MDJGyurgeiz/CAMMES/(commit log)

2026-03-09 Progetto CAMMES completo: PC + Arduino + Android
    - App Windows (cammes.exe) con server Node.js + interfaccia web
    - Pagine: Alzata, Analisi cinematica, Polare, Grafici
    - Sketch Arduino: master.ino + micrometro_SPI.ino
    - App Android con WebView + USB Serial bridge
    - APK compilato pronto per installazione
    [camme-analisi_rev8.5.xlsm]
2026-05-02 Fase A: pulizia e allineamento documentazione/repo
    - Fix README.md: pin stepper corretti (PUL=7, DIR=6, ENA=5), porta HTTP 3000 (era 8080), nota architettura in transizione 2-Uno → 1-Uno
    - CHANGELOG.md: sessione 4 di pulizia, allineato Uno (era Mega), spuntati TODO già implementati ('q' e reset buffer SPI), aggiunti TODO Fase B/C/D
    - Rimossi binari dal tree: cammes.exe, cammes_server.exe, CAMMES.apk (saranno distribuiti via GitHub Releases)
    - Rimossa cartella cammes/charts/ (sorgenti+test+docs Chart.js non necessari a runtime, ~67k righe)
    - Spostato cammes/charts/jquery.min.js → cammes/jquery.min.js, aggiornati riferimenti in alzata.html, polare.html e package.json (config pkg)
    - Rimoss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
2026-05-02 analisi.html: tipologia punteria, forze molla/RPM critico, export CSV/PDF
    Estende la pagina analisi.html per supportare l'analisi completa di camme con
    diverse tipologie di punteria e calcolare il regime critico (cam float).
    UI:
    - Selettore tipologia per intake e exhaust (bicchiere meccanico/idraulico,
    aste+bilancere, finger follower, bilancere a rullo) con default rocker
    e gioco coerenti per ogni tipo. Idraulico forza gioco=0.
    - Nuova sezione "Parametri molla & treno valvole": rigidezza k (N/mm),
    precarico F0 (N), massa equivalente intake/exhaust (g).
    - Nuova sezione risultati "Forze molla e RPM critico": forza inerzia max,
    forza molla a piena alzata, margine minimo, RPM critico pe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
2026-05-02 style.css: redesign 'race telemetry' coerente col contesto camme
    Tutte le pagine adottano un'identita' visiva piu' tecnica e contestualizzata
    all'analisi alberi a camme / motorsport.
    Header (HUD bar):
    - Strip cyan luminosa sul bordo superiore
    - Pattern diagonale di accenti racing nell'angolo destro
    - Logo con drop-shadow ciano
    - Titolo CAMMES con gradient ciano (font display Rajdhani con fallback system)
    - Tab nav con marker sottostante e box-shadow di glow per il tab attivo
    Card (telemetry panel):
    - Sfondo a gradiente verticale (elev -> base) per profondita'
    - Marker cyan verticale a sinistra del titolo (stile HUD)
    - Hover: bordo si rinforza (interazione tattile)
    - Card-title in font disp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
2026-05-03 Fase B: unificazione firmware su 1 Arduino Uno + encoder LDP3806
    Sostituzione completa dell'architettura a 2 Uno (master + sensore via SPI)
    con un singolo Arduino Uno che gestisce: stepper esterno opto-isolato,
    encoder rotativo LDP3806 sull'albero camme (1:1, 360 PPR, decoding x4),
    sensore Neoteck via LM339N, UART verso server PC.
    Pinout finale Uno:
    - D2 (INT0) sensore Neoteck clock impulsi
    - D5 sensore Neoteck DATA
    - D3 (INT1) encoder canale A
    - D8 (PCINT0) encoder canale B
    - D7/D6/D4 stepper PUL-/DIR-/ENA- (driver opto common-anode, 5V su +)
    - D0/D1 UART USB-PC
    Firmware (master/master.ino) riscritto da zero:
    - Lettura sensore Neoteck integrata (16 bit utili, dal 2°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
2026-05-03 firmware: ripristina pin storici stepper (PUL=7, DIR=6, ENA=5), DATA sensore su D4
    Ripristinato il pinout del progetto iniziale per il driver stepper. Il DATA
    del sensore Neoteck (LM339N pin 14) si sposta da D5 a D4, dato che ENA stepper
    torna sul pin storico D5.
    Effetto pratico sul cablaggio: solo 1 filo da spostare sul prototipo (LM339N
    pin 14 da D5 a D4). Tutto il resto resta come da progetto.
    Pinout finale:
    - D2 (INT0) LM339N pin 2 — clock impulsi sensore
    - D4 LM339N pin 14 — DATA bit sensore [spostato]
    - D3 (INT1) encoder A
    - D8 (PCINT0) encoder B
    - D7 stepper PUL- [pin storico]
    - D6 stepper DIR- [pin storico]
    - D5 stepper ENA- [pin storico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
2026-05-03 firmware: fix lettura sensore (LSB mancante) + comandi m/d alzata.html: indicatori stato sensori + fix bug 'mic out'
    FIRMWARE
    - Fix critico: la finestra di lettura del sensore Neoteck era bit 2..17.
    In realtà il sensore mette il LSB sul bit 1, non sul 2.
    Risultato: il valore letto era esattamente la metà di quello vero
    (verificato: comparatore 8.484 mm, digitale 4.24 mm pre-fix; post-fix 8.48).
    - Spostata finestra a bit 1..16. Ora la lettura coincide col display
    del comparatore con scarto < 0.005 mm (rumore di quantizzazione).
    - Nuovo comando 'm': measure-only, legge il sensore SENZA muovere il motore.
    - Nuovo comando 'd': debug, stampa raw value + decimale + binario + bitIdx.
    Ut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
    [full_scan_2026-05-03.csv]
2026-05-03 alzata.html: LED sensore multi-stato + auto-stop su sensore scollegato
    LED Sensore ora ha 3 stati:
    - VERDE: misure valide ricevute negli ultimi 3s
    - GIALLO: arrivano NaN dal firmware (sensore Neoteck scollegato/non risponde)
    - ROSSO: nessun frame dal firmware da > 5s (Arduino non risponde)
    Auto-stop scan: se durante una scansione arrivano 3 NaN consecutivi, la pagina
    ferma automaticamente startflag e chiama stop(). Evita di lasciare il motore
    girare a vuoto se il comparatore si scollega a metà scansione.
    Display 'mic out' rinominato in 'NO SENSORE' (più chiaro per chi non sa cos'e'
    'mic out').
    Bug fix latente: variabili startflag, stepflag, i ora dichiarate esplicitamente
    con var all'in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
2026-05-03 alzata.html: fix bug 'parte a leggere da solo' al reload pagina
    Il blocco di avanzamento scansione (riga 314) si attivava su QUALSIASI
    messaggio che iniziava con '*' (incluso *pos del polling encoder, *zero
    del reset, *dbg del debug). Risultato: ogni 5s il polling '?' riceveva
    '*pos', il vecchio codice lo interpretava come 'misura terminata, vai
    avanti' e mandava 'p' ad Arduino → loop infinito di scansione che
    partiva da solo dopo qualche secondo dal caricamento pagina.
    Fix: condizione molto più stretta:
    - msg === '*se' (solo terminatore di misura, non altri *xyz)
    - AND startflag == 1 (siamo in una scansione attiva avviata da START)
    - AND i < 360 (non superare il giro)
    - AND stepflag ==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
2026-05-03 analisi.html: simulazione bicchiere virtuale (follower geometry 2D)
    Aggiunge una sezione 'Follower simulato' nella pagina Analisi che permette
    di scegliere tra due modalità:
    - Puntalino (raw): usa direttamente la lettura grezza del comparatore
    - Bicchiere piatto Ø configurabile: ricalcola l'alzata che vedrebbe un
    bicchiere virtuale di diametro D senza dover rifare la misura hardware
    ALGORITMO (convertPuntToBicchiere):
    1. Ricostruisce profilo polare camma: r(θ) = r_base + lift_punt(θ)
    2. Per ogni angolo motore α e θ ∈ [0,360):
    x = r(θ) · cos((θ−α)·π/180)
    y = r(θ) · sin((θ−α)·π/180)
    3. Bicchiere piatto orizzontale di larghezza 2·R_bicch tocca la camma
    s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
2026-05-03 firmware + alzata.html: modalità scansione configurabile (stradale ↔ race)
    Aggiunti comandi runtime per cambiare al volo precisione e risoluzione:
    - cN configura N campioni per misura (1..9), media filtrata NaN
    cN=1 (default) 1 campione, ~158 ms/step
    cN=3 media di 3, ~310 ms/step (rumore -42%)
    cN=5 media di 5, ~460 ms/step (rumore -55%)
    - rN configura micropassi per unità di scansione: 8/16/32/64
    r32 (default) 1° camma per p/q
    r16 0.5° camma per p/q (doppia risoluzione angolare)
    r8 0.25° camma per p/q
    - @ stampa configurazione corrente "samp=N step=NN *cfg"
    readSensorMm() ora media filtrata: legge cfgSamples campioni, scar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
2026-05-09 alzata.html: modalità Hyper / Atomic (passo motore minimo + media spaziale)
    Aggiunge due preset di scansione che usano sub-step più piccoli del singolo
    grado camma e aggregano le letture in 360 bin angolari.
    - Hyper: r=4 microsteps → 8 letture per ogni grado camma (~7m30s, ±0.0018 mm)
    - Atomic: r=1 microsteps → 32 letture per ogni grado camma (~30 min, ±0.001 mm)
    ovvero il PASSO MOTORE MINIMO assoluto del sistema
    (1/32 di grado camma = 0.03125°)
    L'aggregazione avviene lato browser nel handler onmessage:
    - subBuffer[deg] accumula tutte le letture del bin angolare 'deg' (1..360)
    - quando il bin si chiude (length === subStep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
2026-05-09 alzata.html: fix bug 'START non parte' dopo movimento manuale o scansione interrotta
    In start() il contatore 'i' non veniva resettato prima di incrementare.
    Se l'utente prima muoveva manualmente l'albero (es. via comandi rotazione)
    o aveva interrotto una scansione lasciando i a un valore alto, il successivo
    START aveva già i >= currentMode.totalSteps. La condizione di avanzamento
    nel onmessage (i < totalSteps) era falsa al primo *se → loop non riprendeva
    mai → 'sembra che non parta'.
    Fix: i = 0 (e consecutiveNaN = 0 per pulizia) all'inizio di start(), prima
    del successivo i = i + 1 che fa partire il primo passo.
2026-05-09 alzata.html: STOP deterministico + bottone '0 VIRTUALE' + fix calcolo per modalita' sub-step
    PROBLEMI RISOLTI
    1. STOP era un toggle: 1° click stepflag=1 (ferma), 2° click stepflag=0
    (riprende). Sequenze come 'scansione → STOP per sicurezza → cambio
    modalità → START' lasciavano stepflag=1 in stati intermedi e il loop
    non avanzava più. Ora STOP = stepflag=1 + startflag=0 + labms=0
    sempre. Per ripartire l'utente preme START, che resetta i=0 e
    ricomincia da capo.
    2. Bottone '0 VIRTUALE' aggiunto nei controlli (chiama ms() che già
    esisteva ma non era esposto in UI). Esegue scansione completa, trova
    maxg (posizione picco), poi sposta automaticamente la camma di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
2026-05-09 alzata.html: rimosso bottone 0 VIRTUALE duplicato
    Il bottone 'Zero virtuale' era già presente nel software originale a riga
    125, accanto ai controlli di rotazione manuale (Ruota / +N° / -N°). Avevo
    inavvertitamente aggiunto un duplicato 'O VIRTUALE' nei controlli principali
    (START/STOP/RESET).
    Mantenuto solo il bottone originale '◎ Zero virtuale' nella sua posizione
    storica. La logica ms() che chiama è la stessa, e il blocco di fine scansione
    (if labms == 1) ha già le migliorie introdotte recentemente:
    - degTarget = (maxg + 180) % 360 (modulo per evitare valori > 360)
    - units = degTarget * subStepsPerDeg (scaling per modalità Race/Atomic)
    - setTimeout 1.5s prima di location.re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
2026-05-09 fix 0 virtuale: config sync browser↔firmware al pageload + robustezza firmware
    PROBLEMA RISOLTO
    Il bottone 'Zero virtuale' eseguiva la scansione, trovava il picco e mandava
    il comando \$+NNN per spostare la camma di +180°. Ma il motore si muoveva
    pochissimo (es. 5° invece di 180°). Causa: il browser e Arduino potevano
    avere config (cN, rN) disallineate dopo un page reload — Arduino conserva
    la config dell'ultima sessione (es. r=1 atomic), mentre il dropdown del
    browser si reimposta su default 'Veloce' (r=32). Il browser calcolava units
    con subStepsPerDeg=1 → mandava \$+255 (per 255° camma in fast), ma Arduino
    con cfgStepsPerUnit=1 (residuo atomic) eseguiva 255 microstep = 7.97° ca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
    [master.ino]
2026-05-09 alzata.html: polling automatico sensore (2s) per LED Sensore in idle
    Prima del fix il LED Sensore restava grigio (vuoto) finché l'utente non
    premeva START. Senza scansione attiva il browser non mandava mai 'm', quindi
    lastSensorAnyRx restava a 0 e il LED non si accendeva. L'utente vedeva
    'Server verde, Encoder verde, Sensore grigio' e pensava che il sensore non
    funzionasse.
    Aggiunto un secondo setInterval che invia 'm' (measure-only) ogni 2 secondi
    in stato idle (startflag != 1). Aggiorna sia il LED Sensore (verde se misure
    fresche, giallo se NaN, rosso se firmware silente da >5s) sia il display
    gauge live anche quando non si sta scansionando.
    Trade-off: ~30 misure/min in idle, costo tras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
2026-05-09 alzata.html: ping immediato + polling sensore real-time (5 Hz)
    PROBLEMA
    Dopo reload pagina:
    - LED Sensore ed Encoder restavano grigi per molti secondi (fino a 5s
    per Encoder, fino a 2s per Sensore)
    - Display alzata 00.00 non si aggiornava finché non arrivava un polling
    - Una volta verdi, il display si aggiornava lento (ogni 2s) → non
    feedback real-time mentre si muoveva il puntalino a mano
    FIX
    1. sendSocket.onopen: 100ms dopo l'apertura del WS, ping immediato di
    'm' (sensore) e '?' (encoder). I LED diventano verdi quasi subito,
    prima ancora che il polling periodico tirochi.
    2. Polling sensore portato da 2s → 200ms (5 Hz). Display 00.00 e gauge
    live si aggiornano fluidi qu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
2026-05-09 alzata.html: log diagnostici 0V + setTimeout reload portato a 2s
    console.log nel blocco labms per tracciare a video (F12 Console) il calcolo
    finale di Zero virtuale: maxg, target, units, modalità, comando inviato.
    Cosi' se l'utente segnala 'non si sposta' possiamo verificare se il browser
    sta calcolando bene o se il problema e' lato firmware/cablaggio.
    setTimeout reload pagina portato da 1500ms a 2000ms per dare margine
    extra ad Arduino di completare il movimento prima che la pagina si ricarichi
    (con il drain buffer del firmware il movimento e' rapido, ma se durante
    si accumulano comandi residui il drain prende qualche ms in piu').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
2026-05-09 firmware: terminatore '*sm' per measure-only ('m'), '*se' resta solo per p/q
    Diagnosticato durante un test end-to-end del 0 virtuale: con piu' tab del
    browser CAMMES aperte, il polling sensore di una tab in idle (5 Hz, comando
    'm') faceva ricevere all'altra tab in scansione un '*se' ogni 200ms. La
    condizione di avanzamento del loop di scansione (msg === '*se') faceva
    incrementare 'i' ad ogni '*se' ricevuto, anche se non era risposta a un
    proprio 'p'. Risultato: la scansione finiva in 1/3 del tempo previsto,
    con dati corrotti (max non aggiornato, maxg=0) e il '$+units' finale del
    0 virtuale veniva calcolato con maxg sbagliato.
    Fix lato firmware (browser non richiede modifiche perche' filtra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
    [master.ino]
2026-05-09 alzata.html: 0 virtuale aspetta ack '*mv' da firmware prima di ricaricare
    Il setTimeout(reload, 2000) era una stima troppo aggressiva: in alcune
    configurazioni (config disallineata, modalità Atomic, polling concorrente)
    il '$+units' inviato non arrivava al firmware in tempo, oppure il reload
    forzato chiudeva il sendSocket prima che il messaggio fosse trasmesso.
    Risultato: la camma non si sfasava di +180° dal picco.
    Browser ora aspetta la conferma '*mv' che il firmware emette a fine
    stepperMove(). Niente più reload arbitrario su timeout: si ricarica solo
    quando si è certi che il motore ha completato il movimento.
    Fallback di sicurezza: se '*mv' non arriva entro 8s (caso pat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
2026-05-09 alzata.html: 0 virtuale - ripristino flusso originale (reload immediato)
    Il codice ORIGINALE dell'utente (commit 3d92bb0) faceva semplicemente:
    sendSocket.send(rgradi2);
    location.reload(true);
    e funzionava. Le mie ultime modifiche (setTimeout, listener '*mv',
    config sync, polling 5Hz) hanno rotto il flusso: il polling 5Hz riempiva
    la coda WebSocket e il setTimeout/reload chiudeva la connessione prima
    che il '$+units' venisse trasmesso.
    - Disattivo TUTTI i timer (clearInterval 1..5000) immediatamente PRIMA
    del send finale: la coda WS si svuota e il '$+units' parte pulito.
    - sendSocket.send(rgradi2) con padding 3 cifre come nell'originale.
    - location.reload(true) immediato come nell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
2026-05-09 0 virtuale fix DEFINITIVO: aggiungo '\n' a tutti i comandi multi-char
    ROOT CAUSE: il nuovo firmware unificato (master.ino post Fase B) richiede
    '\n' per chiamare executeCommand sui comandi multi-carattere ($+NNN, cN,
    rN, ...). Il vecchio firmware originale (commit 3d92bb0) accumulava in
    String e processava qualsiasi '$+NNN' con .length()>4 anche senza newline.
    Quando il browser inviava 'sendSocket.send("$+044")' (senza '\n'), Arduino
    accumulava i 5 byte in cmdBuf ma non eseguiva mai stepperMove. Il movimento
    finale del 0 virtuale si perdeva → la camma non si sfasava → encoder
    mostrava la posizione fine-scansione invece di quella post-sfasamento.
    FIX: aggiungo '\n' a TUTTI gli sendSocke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
2026-05-09 0 virtuale BASATO SU ENCODER reale (non più sul contatore di scansione)
    L'utente ha richiesto la logica corretta del 0 virtuale:
    "il software deve trovare il punto di massima alzata, a quel punto
    corrisponderà un dato valore dell'encoder e questo dato valore dovrà
    essere sommato a 180 gradi al termine della misura, sfasando cosi il
    motore esattamente all'opposto del punto della camma in massima alzata."
    Prima il browser usava 'maxg' (= indice della scansione in unità motore)
    per calcolare il sfasamento. Funziona se 1 unità motore = 1° camma esatto,
    ma con backlash, slittamenti o errori cumulativi del motore il riferimento
    nominale drift dalla posizione angolare REALE della camma.
    FIX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
    [master.ino]
2026-05-09 0 virtuale: usa movimento minimo (modulo 360°), evita giri extra
    Il calcolo precedente (target = maxg_encoder + 720) produceva un movimento
    sempre nella direzione 'positiva', che da posizione corrente -1436 cnt
    poteva richiedere un movimento di +416° (= un giro completo + 56°) anziché
    i 56° del movimento equivalente più corto.
    Posizione fisica finale identica (modulo 360°), ma il giro extra accumulava
    backlash significativo: l'utente notava il puntalino disallineato di alcuni
    gradi rispetto al punto opposto del picco.
    FIX: dopo il calcolo del raw delta (encoderTarget - currentEncoderCount),
    moduliamo a 1440 conteggi (= 360°) e scegliamo il segno che minimizza il
    movimento:
    delta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
2026-05-09 firmware + alzata.html: settle delay configurabile post-stepperMove
    Il motore stepper genera vibrazioni meccaniche residue dopo ogni movimento
    che si trasmettono al puntalino del comparatore Neoteck → letture
    'seghettate' della curva di alzata, soprattutto sui fianchi del lobo
    dove le derivate sono alte e ogni 0.005mm di rumore conta.
    Aggiunto cfgSettleMs (uint16_t, 0..2000) configurabile via comando 'wN':
    w30 → 30ms di delay dopo stepperMove (default per Veloce)
    w200 → 200ms (per camme race con fianchi ripidi)
    La pausa avviene a fine stepperMove() PRIMA di readSensorMm(), così le
    oscillazioni meccaniche del puntalino si smorzano prima del campionamento.
    Comando '@' ora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
2026-05-15 restyling FASE C.7/C.8 + B + A: gauge SVG + progress bar + tooltip + rename
    C.7 gauge moderno SVG inline (cammesGauge.create) sostituisce gauge.min.js 2014
    - Colori da CSS variables, segue tema dark/light senza ridraw
    - Arco progressivo con gradiente accent → accent-2 → danger
    - Tacche maggiori/minori + label, valore mono centrale, glow filter
    - Shim retro-compat: gaugemicrom.value setter + .draw() no-op
    C.8 progress bar scansione (cammesScanProgress.set/reset) + ETA tracker
    - Wrap visivo nei controlli scan di alzata/polare con label + bar + pct + ETA
    - Animazione shimmer durante scan attivo
    - cammesEta.create() stima tempo residuo dalla pendenza misu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
2026-05-15 UX: wizard onboarding + 5 preset motore + toast analisi
    Wizard primo avvio (cammesWizard.show/showIfFirstTime):
    - 5 step modal: Benvenuto → Acquisisci → Zero virtuale → Confronta+Analizza → Suggerimenti
    - Salva flag 'cammes-onboarded-v1' in localStorage; non si ripresenta più
    - Riapribile da bottone "?" in header su tutte le 4 pagine
    - Keyboard: ←/→/Esc, click outside per chiudere
    - Animazione fade + scale bounce; dot navigation in fondo
    Preset motore (selettore in cima a Parametri analisi):
    - Moto stradale 600 (bucket mech, lobo 108°, 12000 rpm, k=35 N/mm)
    - Moto race 1000 (finger 1:1.5, lobo 105°, 14500 rpm, k=75)
    - Auto 4 cyl DOHC (bucket hyd, lobo 112°, 6500 rpm,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
2026-05-15 restyling FASE C.6: upgrade Chart.js 2.x → v4.4.4 + zoom v2 + theme-aware
    Stack nuovo (in cammes/lib/, offline-safe, totale 235 KB):
    - chart.umd.min.js v4.4.4 (linea/polarArea/doughnut)
    - chartjs-plugin-zoom.min.js v2.0.1 (zoom drag su analisi)
    - hammer.min.js v2.0.8 (gesture support)
    API migrate v2 → v4 in tutte e 4 le pagine:
    - xAxes/yAxes → scales.x/scales.y
    - scaleLabel.labelString → title.text
    - gridLines → grid
    - fontColor → color
    - tooltips → plugins.tooltip
    - legend → plugins.legend
    - Chart.defaults.global.X → Chart.defaults.X
    - Chart.Line(ctx,...) → new Chart(ctx, { type: 'line', ...})
    - cutoutPercentage → cutout
    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
2026-05-15 UX polish: A vs B esteso + animazioni entrata + indicatore RPM critico
    A vs B (sezione confronto in analisi):
    - Hero summary: 4 chip KPI a colpo d'occhio (max asp, durata asp,
    area asp %, velocità picco asp) con indicatore cromatico
    pos/neg/neu + barra colorata bottom + freccia ▲▼◆
    - Tabella delta espansa: ora copre 6 metriche × 2 lati (asp + scar):
    max alzata, durata, area, velocità picco, accelerazione picco,
    asimmetria lobo. Ogni cella ha valore A / B + freccia colorata
    con delta in unità o %
    - Toast riepilogo a fine confronto: "B vs A asp.: max +0.8 mm,
    durata +6°, area +12%"
    - Validazione: file mancanti → toast warn invece di alert
    RPM critico indicat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
2026-05-15 Dashboard Home: landing con quick stats + tile + recenti + API files
    Server (cammes_server.js):
    - listMisureFiles(): legge la cartella prove/, ritorna metadata
    [{name, type:'alz'|'pol'|'other', size, mtime}] ordinati per
    mtime DESC. ENOENT → lista vuota (non errore).
    - Endpoint GET /api/files → JSON con array file
    - Endpoint GET /api/file/:name → scarica un .scr/.txt/.csv (con
    protezione path traversal: no '..', no '/' o '\' nel name)
    - Default route '/' ora va a home.html (era alzata.html)
    home.html (nuova pagina, landing):
    - Hero card con welcome dinamico ("N misurazioni salvate. Ultima:
    ...") e 4 quick stat: totale misure, alzata, polare, ultimo file
    - 4 tile colo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
2026-05-15 PDF report ricco: cover branded + 2 colonne + tabella zebra + barra RPM
    exportPDF() ricostruita da zero (~270 righe vs 80):
    Cover page (pagina 1):
    - Banda dark fullbleed 60mm + barra cyan accent
    - Titolo CAMMES 34pt bianco, tagline cyan, timestamp grigio chiaro
    - 4 KPI box grandi (2x2): LSA, Durata asp, Max alzata asp, RPM
    critico min. Bordo sx colorato (cyan/oro/safety-color)
    - Banner sicurezza fullwidth colorato in base al margine RPM
    critico: verde "OK · Margine ampio" (>+50%), giallo "ATTENZIONE
    · Margine stretto" (+5-50%), rosso "CRITICO · Rischio valve float"
    (<+5%). Sotto: target/critico/margine % in dettaglio.
    - Sorgenti file + tipologia treno valvole + rocker
    P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
2026-05-15 Live tuning forze + fix code review: 2 critici + 5 medi
    Live tuning (analisi.html):
    - liveRetuneForces() ricalcola F.inerzia, F.molla, margini, RPM
    critico al volo quando l'utente cambia RPM / k / F₀ / massa eq.
    asp / massa eq. scar SENZA dover ri-premere "Analizza"
    - Aggiorna anche forceChart in place (update('none'), no destroy)
    per latenza < 100 ms anche su PC modesti
    - Debounce 80 ms via setTimeout per evitare ricalcoli a ogni keydown
    - Badge "● Live tuning" (verde pulsante) appare nella sezione
    "Forze molla e RPM critico" dopo la prima analisi
    - Sincronizza lastAnalysis.results/inputs così l'export CSV/PDF
    usa sempre i valori correnti
    - Helper fmtN/fmtRpm/rpmCl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
2026-05-15 Pulizia issue minori + Home: activity chart 14 giorni + bookmarks
    Pulizia issue minori dalla code review:
    - Bitwise '&' → logico '&&' in alzata.html (3) e polare.html (3).
    Funzionava per coincidenza, ora corretto + uso '===' coerente
    - Console.log/warn '[0V]' wrappati in 'if (window.CAMMES_DEBUG)'.
    Console pulita in produzione; il debug si abilita con
    `localStorage.setItem('cammes-debug',1)` o flag URL
    - 'var' aggiunti su fname/stringa2/dg/w in alzata.html (variabili
    globali implicite che inquinavano window)
    - Contrasto WCAG AA light theme: --text-muted #6b7588 → #525a6d
    (ratio ~5.4:1 su bg-input), --text-secondary #4a5365 → #3d4555,
    --text-disabled #a4afc1 → #8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
2026-05-15 Home: ricerca + filtri tipo/data + Replay animato in Confronto
    Home (home.html):
    Refactor loadRecents() → fetch + cache + renderRecentsTable() che
    applica i filtri client-side senza rifare la chiamata al server.
    _cachedFiles condiviso fra fetch e i toggle dei filtri.
    Nuova toolbar sopra la tabella:
    - Search box (icona lente + clear) che filtra per substring nel
    nome file, case-insensitive. Debounce 100 ms via setTimeout.
    - Chip filtro tipo: Tutti / Alzata / Polare / Altri. Chip attivo
    colorato (Alzata=accent cyan, Polare=accent-2 oro, Altri=accent-3
    viola). Selezione esclusiva.
    - Chip filtro data: Sempre / Oggi / 7 g / 30 g. Calcola threshold
    mtime e filtra di co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
2026-05-16 Home: Quick View modal con grafico inline per anteprima file
    Cliccando il nome di un file nella tabella si apre un modal che
    scarica il file dall'API /api/file/:name, lo parsa lato client, e
    mostra:
    - Header: tipo (alzata cartesiana / polare) + nome file
    - 3 stat card: N. punti, Max alzata/raggio (mm), Grado picco
    - Grafico inline Chart.js v4 (linea per _alz, polarArea per _pol)
    con stessi colori/grid del tema dark/light corrente
    - Azioni: Scarica, Apri Confronto, Chiudi
    Parser:
    - parseAlzFile(text): "grado,valore" → labels[] + data[] + max
    - parsePolFile(text): "coseno,seno" → calcola raggio = sqrt(cs²+sn²)
    come labels [1..360] + data[]
    - Robusto a righe vuote/malformate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
2026-05-23 Home: tag/etichette sui file + filtro chip + integrazione Quick View
    Tag system (localStorage 'cammes-tags-v1'):
    - { fileName: ['tag1', 'tag2'] } persistito client-side
    - Tag normalizzati: lowercase, trim, no spazi multipli (→ '-'),
    max 20 char ciascuno
    - API: loadAllTags / saveAllTags / getTagsForFile / addTagsToFile /
    removeTagFromFile / getAllTagsWithCount
    UI tabella Home:
    - Sotto il nome file: badge mini stile chip per ogni tag esistente
    + bottone "+" tratteggiato per aprire prompt
    - Click su badge tag = rimuovi (transizione → rosso con × visibile
    in hover)
    - prompt() per aggiungere/modificare tag (separati da virgola).
    Vuoto = rimuove tutti i tag del file. Toa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
2026-05-23 Auto-tag motore + URL loader Confronto
    home.html — Auto-tag pattern detection:
    - AUTO_TAG_PATTERNS: 21 regex case-insensitive che mappano substring
    del nome file in tag automatici. Esempi: ducati/honda/yamaha/
    kawasaki/bmw/aprilia/ktm per moto; fiat/renault/peugeot/alfa/
    porsche/ferrari per auto; v8/v6/v4/v-twin/inline-4/diesel per
    configurazione cilindri; race/stradale/test-bench/usato per uso;
    prima/dopo per stato temporale; aspirazione/scarico per lato
    valvola
    - Nota tecnica: `\b` finale rimosso dai pattern brand perché
    sarebbe bloccato da underscore (word char). Usa lookahead negativo
    (?![\d]) o (?![a-z]) dove serve disambiguare
    - autoTagFile(name) ritorna a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
2026-05-23 Home: "Confronta preferiti" + card "Tag più usati"
    Bottone "★ Confronta preferiti" (toolbar Home):
    - openBookmarksInCompare() filtra i bookmark per tipo 'alz' (la
    pagina Confronto supporta solo line chart cartesiani) e apre
    grafici.html?files=<top 4 nomi>
    - Toast warn se nessun bookmark esiste
    - Toast warn se nessun preferito è di tipo alzata
    - Toast info se >4 preferiti (carica i primi 4)
    Nuova card "Tag più usati":
    - Bar chart orizzontale, max 8 tag in ordine di count decrescente
    - Layout grid 130px (label) | 1fr (barra) | 50px (count)
    - Barra con gradient accent-3 (viola) → accent (cyan), width
    proporzionale al max
    - Hover row: bg-stripe
    - Click su una row applic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
2026-05-23 Fix bug post-test integrale: durata offset-resistant + replay watchdog
    Bug A (CRITICO) — analisi.html: durata sovrastimata.
    La condizione `lift > 0` contava tutti i 720° se il comparatore
    Neoteck aveva offset residuo (curva non torna mai esattamente a 0
    sul base circle, è normale per uno strumento meccanico). Test sul
    file Clio reale: durata calcolata 673° vs realistico 246°.
    Fix: soglia adattiva `max(0.05 mm, 1% del picco)` — sotto questa
    la valvola è di fatto chiusa anche con offset comparatore.
    Risultato sul caso Clio + Fiat (Auto 4cyl DOHC preset):
    - Durata intake: 673° → 246° (Clio 1.8 stradale, plausibile)
    - Durata exhaust: 608° → 298°
    - Overlap: 4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
2026-05-23 Sblocca motore: free-spin manuale con lettura encoder+sensore live
    Firmware (master/master.ino):
    - Nuovo comando 'f' (FREE): digitalWrite(PIN_ENA, LOW) → driver
    stepper rilascia corrente, l'albero si può ruotare a mano senza
    resistenza. Risponde "*free"
    - Nuovo comando 'l' (LOCK): digitalWrite(PIN_ENA, HIGH) → driver
    riattiva corrente, motore di nuovo in tenuta. Risponde "*lock"
    - Entrambi sono comandi a singolo carattere (esecuzione immediata
    senza attendere \r\n)
    - Encoder e sensore continuano a funzionare regolarmente: l'utente
    ruota a mano e vede dati live
    UI alzata.html + polare.html:
    - Nuovo bottone "🔓 Sblocca motore" nella card "Rotazione manuale"
    - Click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
2026-05-23 Anti-vibrazione stepper: rampa trapezoidale + selettore profilo UI
    stepperMove() ora genera impulsi PUL secondo un profilo trapezoidale:
    - Accelerazione: primi cfgAccelSteps con delay extra decrescente
    - Plateau: velocità nominale (cfgPulseUs)
    - Decelerazione: ultimi cfgAccelSteps con delay extra crescente
    - Movimenti corti: rampa triangolare automatica (max steps/2 per lato)
    Nuovi parametri runtime:
    - cfgPulseUs (50..400 μs) — tempo HIGH/LOW del pulse PUL
    - cfgAccelSteps (0..32) — step della rampa accel/decel
    - cfgRampExtraUs(0..500 μs) — extra delay all'estremo della rampa
    Nuovi comandi seriali:
    - uN pulse width custom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
2026-05-23 🎵 Musical stepper: il motore canta canzoni modulando i pulsi PUL
    Firmware (master.ino):
    - Nuovo comando 'tFFFF:DDDD:S' (tone):
    * FFFF = frequenza in Hz (60..2000)
    * DDDD = durata in ms (10..5000)
    * S = direzione '+' o '-'
    * Imposta DIR, calcola periodo = 1e6 / freq, mezzo periodo per HIGH/LOW
    * Loop di freq*dur/1000 step a frequenza costante (50% duty)
    * Bypassa cfgPulseUs/cfgAccelSteps (vogliamo SOLO un tono puro)
    * Drain del buffer seriale + risposta '*tend' a fine
    - Parsing robusto su ':' con strchr, atoi sui token
    - Docstring aggiornata con il nuovo comando
    UI alzata.html — Music player:
    - Nuovo bottone "🎵 Suona" nella card Rotazione manuale
    - Modal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
2026-05-23 🎼 Home Concerto: 4 brani curati con Inno di Mameli per primo
    Nuovo bottone "🎼 Concerto motore" nella toolbar Home.
    Apre un modal con 4 tile cliccabili, ognuna un brano completo:
    1. 🇮🇹 Inno di Mameli (Inno italiano) — bordo verde tricolore
    * Trasportato in Do maggiore per stare nel range 130-500 Hz
    * Strofe complete + ritornello "Stringiamci a coorte" (la
    parte più riconoscibile)
    * Finale "L'Italia chiamò! SI!" con scala ascendente
    * ~30 secondi di brano
    2. 🎹 Per Elisa (Beethoven) — bordo viola
    * Tema iniziale famoso, 4 frasi musicali
    * Usa D#4, G#3 per le alterazioni cromatiche tipiche
    3. 🎮 Tetris (Korobeiniki) — bordo rosso
    * Melodia ru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
2026-05-23 🔊 Volume controllabile + cleanup bottone Suona obsoleto
    Firmware (master.ino) — duty cycle nel comando tone:
    - tFFFF:DDDD:S[:VV] — quinto campo opzionale: duty in % (10..90)
    - Default 50 (compat). 70 = volume più alto, 90 = massimo
    - Parser usa strchr per terzo ':' opzionale; clamp 10..90
    - Periodo PUL invariato (=> stessa nota), ma highUs/lowUs ridistribuiti:
    * duty 50: 50% HIGH, 50% LOW (neutro)
    * duty 70: 70% HIGH, 30% LOW (più tempo di corrente attiva)
    * duty 90: 90% HIGH, 10% LOW (massimo trasferimento energia)
    - Più tempo HIGH = più energia nelle bobine per ciclo = più vibrazione
    meccanica = volume audio percepito più alto
    - highUs >= 5μs garantito per s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
2026-05-23 3 nuove canzoni italiane + Composer custom (scrivi le tue note)
    HOME_SONGS estesa da 4 a 8 brani. Le 4 originali (Mameli, Per Elisa,
    Tetris, Vivaldi) + 3 nuove italiane + 1 tile compositore:
    Brani aggiunti:
    ✊ Bella Ciao
    - Canto popolare antifascista, riconoscibile mondialmente
    - Da4280ms, 2 strofe complete ("Una mattina mi son svegliato" +
    "E ho trovato l'invasor") con ritornello "O bella ciao"
    - Range A4-D5, sempre in zona dove il motore canta forte
    🌞 'O Sole Mio
    - Canzone napoletana iconica (di Capurro / Di Capua, 1898)
    - 3 frasi: strofe + ritornello "Ma n'atu sole / chiù bello, oje ne'"
    - Range C4-C5, trasportata in Do maggiore
    🎭 Va' pensiero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
2026-05-23 Analizzatore: reset encoder + bookmarks angolari + live trace + backup/restore
    A. Reset encoder + bookmarks angolari (alzata.html):
    - Bottone "↻ Reset zero" → invia '!' al firmware, encoderCount = 0
    - Bottone "📍 Salva pos" → prompt nome, salva (label, deg, encoderCount)
    in localStorage 'cammes-saved-positions'
    - Chip cliccabili sotto: ogni chip mostra label + grado; click =
    goto a quella posizione (calcola sfasamento minimo modulo 360°
    come in 0V); × per cancellare
    - Caso d'uso: definire riferimenti meccanici (base circle, PMS,
    picco aspirazione) e tornarci con un click
    B. Live trace durante free-spin (alzata.html):
    - Nuovo box "Traccia LIVE — ruota a mano per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
2026-05-23 Analizzatore: vista differenza in Confronto + scheda PDF camma singola
    A. Misurazione differenziale (grafici.html):
    Nuovo selettore "Vista" accanto a Replay:
    - Sovrapposto (default): comportamento esistente
    - Differenza vs file 1: calcola delta = file_k - file_1 per ogni
    grado camma. Mostra le N-1 curve come scarti dalla baseline,
    la baseline diventa una linea zero di riferimento
    Stats post-calcolo nella card title:
    - |Δ| max (mm): peggior scarto puntuale — color-coded
    - |Δ| medio (mm): scarto medio assoluto
    - RMSE (mm): radice della media degli scarti²
    - "N vs baseline" conteggio confronti
    Soglie color: >0.5 mm rosso, >0.1 mm giallo, altrimenti neutro
    Backup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
2026-05-23 Audit fix + 2 nuovi follower (roller + finger) + R puntalino sottratto
    Audit indipendente ha identificato 2 issue critici + 4 cosmetic.
    CRITICO 1 — mapCamToCrank wrap manuale rotto su angoli dispari:
    La cascata di if con limiti arbitrari ("p > 0 && p < 3" wrap)
    lasciava slot non popolati per certi valori di angle. Sostituita
    con modulo wrap720() esplicito che gestisce qualunque input:
    p = ((d*2 ± angle - 1) % 720 + 720) % 720 + 1
    Funzionalmente identica per casi normali, robusta a edge cases.
    CRITICO 2 — rPunt non sottratto in convertPuntToBicchiere:
    La scansione col puntalino sferico (raggio rPunt) misura un offset
    di rPunt rispetto alla superficie reale della cam. Adesso il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
2026-05-23 Race-grade: finger esatto + compliance treno valvole (RK4)
    A) Finger follower geometricamente esatto:
    convertPuntToFinger ora accetta parametro tiltDeg (angolo iniziale
    del braccio camma rispetto all'orizzontale, default 0°).
    Formula esatta: per ogni lift cam Δh, il finger ruota di
    Δφ = asin(sin(θ_cam_0) + Δh/L_arm) − θ_cam_0
    Poi l'estremità valvola si muove di
    ΔX_valve = L_valve·(sin(θ_val_0 − Δφ) − sin(θ_val_0))
    Convenzione: θ_val_0 = -θ_cam_0 (bracci simmetrici opposti).
    Con tilt=0 e bracci colineari → riduce esattamente al rocker
    ratio L_valve/L_arm (backward compatible).
    Per grandi alzate / tilt > 20° diverge dalla versione lineare,
    catturando la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
2026-05-23 CHANGELOG: documenta sessione 6 (restyling completo + race-grade)
    Riepilogo strutturato dei 35+ commit della sessione, raggruppati in 7
    aree (A: design system, B: Chart.js v4, C: dashboard, D: analisi
    race-grade, E: firmware, F: UI motoristica, G: code quality).
    Marca tag versione v2.0.0-race-grade.
    Aggiornati i TODO storici: Fase C completata in pieno (LED status,
    export CSV+PDF, progress bar con ETA, ottimizzazione timing motore
    con rampa accelerazione + 4 profili anti-vibrazione).
    Documentate prossime feature candidate per sessioni future
    (grafico valvola dinamica, sweep RPM, optimizer molla, modello
    compliance 2-DOF).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
2026-05-24 Analisi avanzata: grafico compliance + sweep RPM + optimizer + 2-DOF
    5 nuove feature race-grade implementate e testate sulla Clio reale.
    ### 1. Grafico valvola dinamica (createComplianceChart)
    Nuovo chart Chart.js v4 inline in analisi.html (auto-hide se compliance
    OFF). Mostra 4 linee + 2 zone:
    - cam asp. imposta (tratteggiata cyan sottile)
    - valvola asp. reale (cyan grossa, dal solver RK4)
    - cam scar. imposta (tratteggiata rossa sottile)
    - valvola scar. reale (rossa grossa)
    - zona "valve float" semitrasparente rossa dove cam - valvola > 0.02 mm
    Chiamato da analyze() dopo createForceChart.
    ### 2. Sweep RPM (rpmSweep + runRpmSweep)
    Bottone "📉 Sweep RPM" abilitato dopo analyze. Esegu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
2026-05-27 PDF/CSV: integra compliance + CHANGELOG sotto-sessione 6.2
    Export esteso con i dati compliance (quando attiva):
    - PDF: nuova pagina grafico "Compliance cam vs valvola reale (RK4)"
    via addChartIfPresent(complianceChart). Nuova riga "Valve float
    dinamico" nella tabella risultati con valore mm + posizione gradi
    per asp e scar.
    - CSV: 4 righe valve float dinamico (asp/scar in mm e gradi).
    Esportate solo se R.complianceOn = true.
    CHANGELOG: documentata sotto-sessione 6.2 (analisi race-grade) con
    le 5 feature (grafico compliance, sweep RPM, optimizer molla, 2-DOF,
    fix k_train). Aggiornati i TODO completati. Tag v2.1.0-race-analysis.
    Test PDF con compliance ON (Clio, Auto 4cyl, 6500 rpm):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
2026-05-27 Analisi race-grade: mappa molla k×F0 (heatmap) + Race report PDF
    - springMap(): griglia 16×14 (224 combinazioni) di valve float al variare
    simultaneo di rigidezza k e precarico F0, calcolata via simulateCompliance
    - renderSpringMap() + _floatToColor(): heatmap su canvas springMapCanvas,
    verde <0.1mm / giallo 0.1-0.3 / rosso >0.3, marker ◎ sulla molla attuale
    - runSpringMap() / btnSpringMap: pulsante "Mappa molla" (~8s)
    - exportRaceReport() / btnRaceReport: PDF dedicato all'analisi dinamica
    (sweep RPM + molla ottimale + mappa k×F0 + grafico compliance)
    - wire-up: pulsanti abilitati in analyze() quando compliance ON,
    disabilitati in resetAll(), canvas nascosto in sweep/optimizer
    -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
2026-05-27 Compliance 3-DOF: cedevolezza sede valvola + valve bounce
    - simulateCompliance3DOF(): catena cam→bilancere(m1)→valvola(m2)→sede(m3).
    La sede è una massa richiamata a terra da k_seat (rigidezza testata/insert)
    + smorzamento; contatto valvola-sede unilaterale (penalty su gap g=x2-x3<0).
    Cattura il valve bounce alla chiusura, modo di guasto assente in 1/2-DOF.
    Solver RK4 a 6 stati; passo legato al modo più rigido, cap subStep anti-freeze.
    - UI: opzione "3-DOF (sede)" nel dropdown complianceModel, righe param massa
    sede (15 g) e k sede (80000 N/mm) mostrate solo in 3dof; on2DofToggle esteso
    (bilancere condiviso 2/3-DOF). Dispatch in analyze().
    - tools/test_3dof.js: regression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
2026-05-27 Validazione modello su Clio 1.8 16V reale + tracciabilità modello negli export
    - tools/validate_clio.js: estrae la pipeline di produzione (parseCamFile →
    mapCamToCrank → solver 1/2/3-DOF + detectValveFloat) da analisi.html via
    brace-matcher e la applica alla scansione reale prove/clio_test_1_alz.scr.
    Verifica fisica: il motore F7P è DOHC a punteria diretta → 1-DOF è la
    topologia corretta → float a 7000 rpm = 0.091 mm (trascurabile, come deve
    essere per un motore di serie sano). 6/6 check PASS.
    Camma confermata: picco 8.60 mm, durata 246° (coerente col reale).
    Mostra anche che 2/3-DOF sovrastimano (modellano un pushrod assente) →
    monito: il modello va scelto in b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
2026-05-27 Sweep 3D interattivo k×F0×RPM (nuvola ruotabile)
    - sweep3D(): griglia 8×8×6 = 384 combinazioni (k, F0, rpm) di valve float
    via simulateCompliance; dati cachati (ruotare ri-proietta, non ri-simula).
    - _project3d() + render3DSweep(): proiezione ortografica su canvas con
    azimuth/elevation, painter's algorithm per la profondità, cubo di
    riferimento + etichette assi, punti colorati per float (verde/giallo/rosso),
    marcatore verticale giallo sulla molla attuale. Nessuna libreria 3D esterna.
    - _bindSweep3dDrag(): rotazione drag mouse + touch (una bind per canvas).
    - run3DSweep() + btnSweep3D "Sweep 3D"; mutuamente esclusivo con la mappa 2D
    (nasconde/mostra i canvas). Abilitato in anal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
2026-05-27 Analisi UX: modalità Base / Avanzato sulla stessa schermata
    Audit usabilità da nuovo utente: la pagina Analisi era un muro (24 input +
    13 pulsanti sullo stesso piano, nessun percorso minimo). Introdotto un toggle
    "Base | Avanzato" nell'intestazione della card Parametri — progressive
    disclosure NON distruttiva, sulla stessa schermata (niente compartimenti).
    - Base (default nuovi utenti): solo l'essenziale per un'analisi completa —
    preset, import asp/scar, tipologia/angolo lobo/gioco, RPM, rif. durata,
    molla k/F0/massa, Analizza/Reset/CSV/PDF.
    - Avanzato: rivela in posto Anticipo, bilancieri, smooth, follower simulato,
    compliance dinamica e i 5 strumenti race.
    - I campi nascosti r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
2026-05-27 Home UX: fix tabella misure sempre vuota + Concerto fuori dalla toolbar dati
    - BUG: la tabella misurazioni della Home era SEMPRE vuota. loadRecents()
    calcolava le statistiche dall'array fetchato ma non assegnava mai
    _cachedFiles, che è la sorgente letta da renderRecentsTable/auto-tag/
    activity/count. Risultato: header "8 misurazioni" ma lista "0 / nessun
    file salvato". Fix: _cachedFiles = files in loadRecents(). Ora header e
    lista concordano (verificato: 8 = 8) e la tabella (ricerca, filtri, tag,
    apri, confronta) funziona davvero.
    - Spostato "Concerto motore" dalla toolbar dati all'header (icona 🎼 accanto
    a guida/tema): era sorprendente in mezzo a Export/Import/Auto-tag. La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
2026-05-27 UX audit: caption orientative su Alzata/Polare/Confronto
    Completati i restanti rilievi dell'audit usabilità (nuovo utente):
    - Alzata: caption sotto "Rotazione manuale e zero" che spiega in una riga
    cosa fa "Zero virtuale" e "Sblocca motore" (termini invariati, i tooltip
    per-pulsante esistevano già — mancava l'orientamento a colpo d'occhio).
    - Polare: caption analoga sotto "Rotazione manuale" (Sblocca motore).
    - Confronto: caption sotto "Dati misurazione" che spiega il flusso (carica
    fino a 4 file _alz/_pol) e cosa sono le righe grafico 1–4, così lo stato
    iniziale a zero non sembra rotto.
    - CHANGELOG 6.5 aggiornato con tutte le azioni dall'audit (incluso il fix
    della tabella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
2026-05-27 Alzata/Polare: banner "nessun hardware" + guardia START disconnesso
    Scenario nuovo utente: apre la pagina senza Arduino/server e non capisce
    perché START non fa nulla. Aggiunto feedback chiaro:
    - Banner contestuale (giallo) sotto l'header che distingue due casi:
    "server non raggiungibile (avvia cammes_server.js)" vs "server ok ma
    nessun dato dall'Arduino (controlla USB/firmware)". Grazia iniziale per
    non lampeggiare durante l'handshake WebSocket.
    - start() e ms() (Zero virtuale) ora bloccano con toast "Server non
    connesso" se i WebSocket non sono pronti. In Polare questo risolve anche
    un crash latente: start() chiamava sendSocket.send() che lanciava
    ReferenceError se il server n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
2026-05-29 Fix export PDF: grafici non più schiacciati né bianchi
    Segnalazione utente: grafici assenti/bianchi e tagliati/disallineati in tutti
    gli export. Diagnosi via pixel-sampling del canvas esportato.
    - Helper chartToPrintImage(): compone il canvas Chart.js su fondo BIANCO opaco
    a 2x risoluzione e ritorna l'aspect ratio reale; resize se buffer vuoto,
    null → placeholder invece di riquadro muto.
    - addChartIfPresent + blocco timing: altezza = larghezza × aspect (niente
    squish, prima h fissa 55/60mm su canvas aspect ~0.6), page-break su altezza
    vera, "(grafico non disponibile)" esplicito quando il chart manca.
    - exportRaceReport: compliance via helper; spring map in modalità stampa
    (r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
2026-05-30 test_followers.js: regressione conversioni follower virtuale
    Estrae convertPuntToBicchiere/Roller/Finger da analisi.html (brace-matcher,
    niente copia-incolla) e verifica invarianti DERIVATE dal codice:
    - Roller: out = max(0, raw - rPunt); rRoll ininfluente (approssimazione)
    - Finger tilt=0: out = raw * (lValve/lArm) esatto (err 1e-15); identità se uguali
    - Bicchiere: finito/≥0, picco ≈ picco grezzo (al naso = alzata picco), rPunt sottratto
    8/8 PASS.
2026-05-30 PDF: colori grafici scuriti in stampa (contrasto su bianco)
    Le linee dati del tema scuro (cyan #00d4ff, giallo) sbiadivano su pagina
    bianca. Aggiunti in chartToPrintImage:
    - _darkenForPrint(): scurisce i colori chiari (lum>150 → ×0.5), lascia i fill
    traslucidi e i colori già scuri; gestisce hex/rgb/rgba/array.
    - _applyPrintPalette(): prima della cattura scurisce borderColor/backgroundColor
    dei dataset, testo/legenda → #222, griglia → #ddd; salva e ripristina dopo.
    - Fix chiave: update('none') NON ridisegna sincrono il canvas → aggiunto
    chart.draw() esplicito, così la cattura vede i colori da stampa.
    home.html exportSinglePDF: stessa logica inline (border scuro + draw()).
    Ve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
2026-05-30 Auto-reconnect WebSocket (alzata + polare)
    Se il server cade, il browser ritenta da solo ogni 3s senza reload; i LED/
    banner tornano verdi alla riconnessione + toast "Connessione ripristinata".
    - handler onopen/onmessage convertiti in funzioni nominate (_engineOnOpen/
    _engineOnMessage); connectEngine() li ricollega e aggiunge onclose/onerror.
    - onclose/onerror programmano un singolo retry dopo 3s (guard _engineReconnectTimer),
    salvo chiusura intenzionale (window._cammesClosing).
    - sendSocket viene ricreato nell'onopen ad ogni riconnessione.
    Verifica live: connessione iniziale OK; forzato close → riconnesso entro ~2.5s
    su entrambe le pagine; nessun errore console.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
2026-05-30 Allarme slittamento stepper↔encoder durante scansione
    Confronta i passi comandati con l'avanzamento reale dell'encoder (4 conteggi/
    grado camma) su una finestra di 10° camma. Se l'encoder si è mosso meno del
    25% dell'atteso (40 conteggi/10°), il motore sta probabilmente slittando
    (accoppiamento lasco, cinghia, stallo) → toast di avviso, una volta per run,
    non blocca la scansione.
    - Mode-independent (10° = 40 conteggi attesi in ogni modalità); guard
    expected>=16 e wrap-safe mod-1440 sul delta encoder.
    - Conservativo: il backlash (pochi conteggi) non genera falsi allarmi; solo
    l'encoder quasi fermo fa scattare l'avviso.
    - Logica soglia validata numericamente (sano 40/37 → no al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
2026-05-30 CHANGELOG: sotto-sessione 6.7 (test follower + contrasto PDF + reconnect + allarme encoder)
2026-05-30 Fase D: setup ESLint (config flat + lint/test scripts)
    - cammes/eslint.config.js: flat config, globals inline (no dep `globals`),
    regole curate pro-bug (no-undef, no-dupe-keys, valid-typeof, no-func-assign,
    no-eval...) senza rumore di stile sul codice ES5 (var, catch vuoti ammessi).
    Copre cammes_server.js (Node), cammes-ui.js (browser), tools/*.js (Node).
    Script inline HTML esclusi (richiederebbero plugin + molto rumore).
    - package.json: script "lint" e "test"; eslint dichiarato in devDependencies.
    - Fix dai finding: documentato il monkey-patch intenzionale di close()
    (no-func-assign) in cammes-ui.js; disable mirati per eval()/window stub nei
    tools. Lint finale: 0 errori, 1 warni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
2026-05-30 CHANGELOG: sotto-sessione 6.8 (Fase D — ESLint + 5 issue GitHub)
2026-05-30 Fix #5: pkg.assets allineato ai file reali (build standalone)
    pkg.assets era fermo a prima della migrazione: elencava 4 file inesistenti
    (gauge.min.js, Chart.min.js, Chart.bundle.js, jquery.min.js) e ne mancavano
    di essenziali → l'exe pkg sarebbe stato incompleto.
    Corretto in base ai src/href reali degli HTML + url() del CSS:
    - aggiunti: home.html (landing!), cammes-ui.js (UI condivisa), lib/**/*
    (Chart.js v4 + zoom + hammer), fonts/**/* (5 woff2 usati da style.css)
    - rimossi i 4 riferimenti morti
    - mantenuti: style.css, jspdf.umd.min.js, responsivevoice.js, images, prove
    Verifica statica: package.json JSON valido; 0 entry non-glob inesistenti;
    18/18 file referenziati da HTML/CSS coper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
2026-05-31 #1 Spring surge: modello molla a massa distribuita (modi delle spire)
    I solver compliance trattavano la molla come F=F0+k·x (massa concentrata):
    non vedevano il SURGE, la risonanza longitudinale delle spire ad alto regime.
    - simulateSpringSurge(valveLift720, rpm, params): molla discretizzata in N masse
    (m_spring/N), N+1 segmenti in serie k=(N+1)·kSpring, base fissa, capo guidato
    dal moto valvola, RK4. Ritorna surgeFreqHz, surgeRatio, maxCoilAmp,
    harmonicOrder, criticalRpm. springSurgeFreqHz() = ½·√(k/m). Analisi
    disaccoppiata (surge dato il moto valvola, non retroagisce sul float).
    - UI: select "Surge molla" + righe massa molla / spire attive (nel gruppo
    compliance), toggler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
2026-05-31 #2 Compliance 3-DOF: cedevolezza pivot bilanciere (opzionale)
    Il 3-DOF modellava il bilanciere (m1) come massa libera tra k_push (cam) e
    k_train (valvola): pivot infinitamente cedevole. Aggiunto un terzo lato di
    cedevolezza, il PERNO/albero del bilanciere verso la testata.
    - simulateCompliance3DOF: nuovo param kPivotN_mm; termine -k_pivot·x1 (+ damping)
    nell'accelerazione di m1. Default 0 = perno libero = 3-DOF originale invariato
    (retrocompatibile). Valori finiti = perno con rigidezza propria.
    - UI: riga "k pivot bilanc." nel gruppo 3-DOF (default 0 = libero), toggler.
    - Dispatch in analyze() (ramo 3dof).
    - test_3dof.js CHECK 4: k_pivot=0 ≡ assente (diff 0, retrocompat esatta);
    k_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
2026-05-31 #4 Tour guidato passo-passo (coachmark per-pagina)
    Oltre al wizard di benvenuto (testuale, automatico a prima visita), aggiunto
    un TOUR on-demand che evidenzia i controlli REALI della pagina corrente, uno
    alla volta, con spotlight + tooltip e navigazione Indietro/Avanti/Fine + ESC.
    - Tutto in cammes-ui.js (niente modifiche ai 5 HTML né a style.css): il
    bottone 🗺 "Tour" è iniettato accanto al "?" in init() su tutte le pagine
    note; la CSS .cammes-tour-* è iniettata da JS.
    - getCurrentPage() da document.title; TOUR_STEPS per pagina (home/alzata/
    polare/grafici/analisi) con selettori sugli id reali (#scanMode, #msBtn,
    #freeBtn, #modeBaseBtn, #fileIntake, #complianceEnabled, #surge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
2026-06-01 Surge vs RPM: grafico del surge ratio al variare del regime
    Completa la feature spring surge con la vista mancante (era nei "da fare").
    - surgeSweep(): 36 regimi (1.5k-12k rpm), surge ratio per ciascuno, trova il
    picco (regime di risonanza della molla).
    - renderSurgeSweep(): curva surgeRatio vs rpm su canvas, soglia 1.0 (rosso),
    marcatore regime attuale, label freq di surge.
    - runSurgeSweep() + bottone "🎶 Surge vs RPM" nella riga race (abilitato dopo
    analisi, guard se surge OFF). Mutuamente esclusivo con gli altri canvas race
    (hide reciproco). Enable in analyze(), disable in resetAll().
    - Verifica browser: picco surge 2.00 @ 10200 rpm (critico) su molla soft,
    chart disegnato (57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
2026-06-01 Animazione 2D del meccanismo cam+follower+valvola (analisi)
    Mostra a monitor "cosa fa la macchina": vista laterale animata su canvas 2D
    puro (zero dipendenze, offline-safe — niente Three.js/WebGL per il vincolo
    exe officina).
    - cammes-ui.js: modulo condiviso window.cammesCamAnim — drawCamMechanism()
    disegna camma rotante (lobo polare r=rBase+lift), follower per tipo
    (bicchiere/rullo/dito) alla quota di contatto, stelo+testa valvola che apre
    di lift×rocker, molla a spire che si comprime, tacca di fase, readout
    angolo/alzata/valvola. createCamAnimator() con rAF + watchdog setTimeout.
    - analisi.html: card "Animazione meccanismo" (canvas + play/pausa + slider
    velocità + selettor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
2026-06-01 Fix roller follower: inviluppo radiale reale (non più placebo)
    L'audit ha confermato che convertPuntToRoller ignorava rRoll (out = max(0,
    raw−rPunt), il test stesso lo asseriva): "roller" era equivalente al puntalino.
    Sostituito con la cinematica esatta dell'inviluppo radiale: il centro del
    rullo traccia la pitch curve (cam offset di rRoll lungo la normale),
    d(α) = max_θ [ρcosΔ + √(rRoll²−ρ²sin²Δ)], alzata = d(α) − (rBase+rRoll).
    - Limite rRoll→0 ⇒ profilo puntalino (esatto).
    - rRoll finito: il rullo non entra negli incavi e arrotonda naso/fianchi.
    - test_followers.js aggiornato (9/9): rRoll→0=puntalino; rRoll=8 cambia
    l'output (Δ 0.607mm, non più inerte); rRoll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
2026-06-01 Fix reali audit: warning saturazione finger + guard divergenza solver
    - convertPuntToFinger: quando asin satura (alzata > corsa del braccio camma)
    la curva era troncata in silenzio. Ora setta window._fingerSaturated e
    applyVirtualFollower mostra un toast "Geometria leva insufficiente" (una
    volta) invece di numeri silenziosamente sbagliati.
    - analyze(): guard anti-divergenza sulla compliance — se l'alzata valvola
    simulata è non-finita o assurda (>3× picco cam, possibile sotto-risoluzione
    a k_seat estremi col cap subSteps) → toast "Compliance instabile". Verificato
    che NON falsi-allarma su risultati estremi ma validi (solver robusto).
    - style.css: aggiunto .cammes-tour-hole a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
2026-06-01 Vista meccanismo LIVE in alzata: cosa fa la macchina ORA
    Canvas nella card "Misura in tempo reale": il meccanismo (camma+follower+
    valvola+molla) orientato all'angolo encoder REALE (currentEncoderCount/4) con
    il follower alla quota del comparatore live. Se è stata acquisita una
    scansione (pdata) disegna il profilo reale che ruota; altrimenti cerchio base.
    Riusa il modulo condiviso window.cammesCamAnim; redraw ~10 fps solo se il
    canvas è visibile. Aggiunto window._liveLift accanto all'update del gauge.
    Verifica browser: canvas visibile, redraw al variare di encoder/lettura
    iniettati (8.6k px), 0 errori console. Draw-only: nessuna modifica alla
    logica di scansione/comunicazione.
    Co-Authore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
2026-06-13 Alzata al PMS corretta: compensazione puntalino + riferimento al picco + raggio base per lato
    Caso reale VW KR 1.8 16V: il software dava 1.7/1.0 mm di alzata al PMS,
    attesi ~3.5/3.3. Tre cause reali corrette:
    1. Bug bicchiere: 'ltrue = raw - rPunt' (sottrazione piatta) abbassava tutta
    la curva di 1.5mm anche al naso, facendo leggere il bicchiere MENO del
    puntalino (impossibile). Sostituito con compensazione a offset normale
    (stylusCompensate): lift_vero = raw + rPunt*(1-cos a), >=0, nulla al naso,
    cresce sui fianchi. Condivisa da bicchiere/rullo/finger. Picco preservato.
    2. PMS ancorato all'origine scansione (anlIn[361], punto arbitrario) ->
    ora riferito al PICCO MISURATO: a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
2026-06-13 Salva profilo (grezzo o gia convertito) in archivio
    Feature: dalla pagina Analisi un unico bottone 'Salva profilo' scrive un .scr
    in prove/ (visibile in Home). Il menu Tipo follower decide cosa si salva:
    - Puntalino -> curva grezza (header _pline);
    - bicchiere/rullo/finger -> curva gia convertita col follower scelto, con
    header marcatore _pline_conv:tipo:param + suffisso nome (_bicch35/_roll8/_finger).
    Anti doppia-conversione: caricando un file _pline_conv l'analisi forza follower
    = Puntalino e avvisa, cosi non riconverte una curva gia-follower.
    Server: nuovo handler POST/PUT /api/file/<nome>.scr che scrive in prove/
    riusando isSafeFilename + guardia path-traversal; solo .scr, body cap 2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
2026-06-14 Pulizia codice morto (referto audit campi UI)
    Audit esaustivo (255 elementi UI, 247 ok, 0 doppioni, 0 rotti, verifica
    adversariale): rimossi i residui morti/vestigiali confermati. Nessun
    cambiamento funzionale.
    - alzata.html: rimosse funzioni orfane insert() (placeholder) e update()
    (copia-incolla da polare, refs birdsData/polarAreaChart inesistenti, mai
    chiamata). reset() resta (in uso).
    - home.html: rimosso checkbox nascosto #filterBookmarked (vestigiale, .checked
    mai letto; il toggle usa label+icona + var filterOnlyBookmarks).
    - cammes-ui.js: rimosse 3 esposizioni window.* mai usate (cammesToggleTheme
    dup dell'handler interno; cammesWizard.reset + resetWizardFlag;
    cammesGetCurr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
2026-06-14 Correzione baseline/eccentricita del cerchio base (bonifica acquisizione b)
    Lo scarico VW ha un fondo di cerchio base ~0.21mm variabile lungo il giro
    (camma fuori centro / runout): non e un offset costante.
    removeCamBaseline(): stima la baseline come DC + 1a armonica (a0+a1cos+b1sin,
    minimi quadrati 3x3 via Cramer) sui SOLI punti di cerchio base (lobo + rampe
    esclusi con margine +-12 per non falsare il fit) e la sottrae a tutta la
    curva. Su scansioni pulite il fit ~0 -> no-op. Toggle 'Corr. baseline' ON/OFF
    (default ON). Cablata in analyze() (analysisRaw, prima del follower) e nel
    salva-convertito; il salva-grezzo resta il dato come misurato.
    test_baseline.js (nuovo): camma pulita -> no-op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
2026-06-14 Indicizzazione profilo su encoder (bonifica acquisizione a)
    Oggi il profilo e indicizzato sui PASSI del motore; l'encoder reale (4 cnt/grado)
    e letto ma usato solo per zero-virtuale e allarme slittamento. Se lo stepper
    slitta sotto carico, i passi non corrispondono alla rotazione vera -> profilo
    deformato.
    - Selettore 'Sorgente angolo: Passi (default) / Encoder' in alzata.html.
    Default Passi (storico, noto-buono): encoder opt-in finche non validato al banco.
    - pdEncoder[]: memorizza il conteggio encoder per grado durante la scansione.
    - reindexByEncoder(): al salvataggio re-indicizza sulla posizione reale (offset
    riferito al 1o campione, direzione dal segno dello span, aggrega per
    gra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
2026-07-04 UI a moduli: schermata pulita di default, funzioni extra a spunta
    Il programma era diventato complicato per chi deve solo analizzare i profili
    asp/scarico e correlarli (gradi di apertura + grafico). Ora la schermata di
    default mostra solo l'essenziale; le funzioni extra sono moduli attivabili.
    - Pannello '⚙ Funzioni' nell'header Parametri: 7 checkbox persistenti
    (localStorage cammes-modules-v1): follower simulato, molla & forze,
    cinematica, dinamica valvole (compliance+surge), strumenti race,
    animazione meccanismo, confronto A/B. Default: tutte OFF.
    - Ogni blocco e taggato data-module="a b c": visibile se almeno un modulo
    e attivo -> dinamica/race portano con se i parametri molla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
2026-07-04 F2: matematica in lib/cammes-math.js condivisa browser+node
    Revisione architetturale, fase 2: le 16 funzioni di calcolo puro (~39KB) escono
    dall'HTML e diventano una libreria condivisa.
    - lib/cammes-math.js (UMD): nel browser aggancia le funzioni a window con gli
    stessi nomi globali di prima (pagine invariate); in node module.exports.
    Alias interno window=root per lo stato diagnostico (_lastBaselineAmp, ...).
    - Estratte con chirurgia scriptata (stesso brace-matching dei test -> copia
    esatta): baseline (_det3/_solve3/removeCamBaseline), follower
    (stylusCompensate/convertPuntTo*), mapCamToCrank, parseCamFile, compliance
    1/2/3-DOF + detectValveFloat, surge (freq+sim) da analisi.html;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
2026-07-04 F3: livello acquisizione condiviso cammes-scan.js (dedup alzata/polare)
    Revisione architetturale, fase 3: le due pagine di scansione avevano ~450
    righe in copia. Le 7 funzioni IDENTICHE (verificate con confronto normalizzato
    automatico) escono in cammes-scan.js: stato+connessione WebSocket con
    auto-reconnect (_wsReady/connectEngine/_engineScheduleReconnect), invio
    profilo movimento (onMoveProfileChange), jog manuale (m1/p1) e inversione
    senso (rlb), piu il blocco di stato condiviso (WS_URL/engineSocket/...).
    Contratto: la pagina definisce _engineOnOpen/_engineOnMessage (parsing
    specifico) e poi chiama connectEngine(). Le funzioni divergenti
    (toggleMotorFree, _setMotionUiDisabled, ruota, upd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
2026-07-04 F1: scan autonomo nel firmware (v3) + settle adattivo
    Revisione architetturale, fase 1: il ciclo di scansione si sposta dal browser
    all'Arduino.
    master.ino v3:
    - Comando S+/-NNNNN: per ogni unita muove, legge con settle ADATTIVO
    (readSensorStableMm: due frame consecutivi entro 5um = stabile, budget
    1.5s/punto - veloce sul cerchio base, paziente sul fianco ripido, mirato
    al fianco sottostimato emerso dal confronto col banco) e streama
    '#i:enc:mm' (i = sequenza -> buchi rilevabili). Fine *sdone; abort 'x' ->
    *sabort. Query 'v' -> ver=3.0 scan=1. p/q invariati (jog/compat).
    readSensorMmOnce rifattorizzata su readSensorMmOnceT(timeout).
    Compila: 8584B flash (26%), 261B RAM (12%).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
2026-07-04 F4: consegna da prodotto (hot-plug, versione in UI, docs, build)
    Revisione architetturale, fase 4 (fine ultimo: prodotto da distribuire).
    - Hot-plug seriale: se all'avvio non c'e' l'Arduino, il server ricontrolla le
    porte ogni 5s finche' non compare (avvio exe prima dell'USB, senza riavvii).
    Retry anche su errori di apertura/list; log una-tantum.
    - Badge versione su ogni pagina (CAMMES v3.0.0, cammes-ui.js,
    window.CAMMES_VERSION): in assistenza si sa quale build gira.
    - README riscritto (era fermo a marzo: citava file rimossi): architettura v3,
    protocollo S/x/v, quickstart, Android marcato SPERIMENTALE.
    - MANUALE_OPERATORE.md (1 pagina): avvio, misura, analisi, problemi frequenti.
    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
2026-07-05 Validazione al banco + fix starvation RX FTDI (keep-alive seriale)
    Campagna di validazione autonoma sul sistema completo (Arduino COM8 +
    stepper + encoder + Neoteck + camma Clio 1.8 16V installata):
    - Firmware v3 VALIDATO: scan autonomo S-00360 -> 360/360 campioni, 0 buchi,
    0 NaN, 76.6s; profilo identico al classico (picco 8.52 vs 8.51, RMS
    0.079mm). Settle adattivo misurato: 193ms base vs 264ms fianco ripido.
    - Calibrazione B1 CHIUSA: mosse di scansione 0.9986 deg/unita (esatte);
    rotazioni lunghe continue +0.83% overshoot, 0 backlash, ritorno esatto.
    Divergenza passi<->encoder in scan: 1 grado -> slittamento ESCLUSO.
    - reindexByEncoder validata su dati live.
    - Ripetibilita: RMS 0.0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
2026-07-05 Report tecnico camme VW KR: consolidamento 4 fonti + analisi fasatura 106/108
    Report (MD + PDF stampabile 2 pagine) che consolida tutte le misure sulle
    camme 257a/257s: scansione CAMMES, scheda Motor Rettifica, due rilievi al
    motore (06-14 e 07-05, incluso il nuovo set: asp 43-67 hPMS 3.5 max 11.1;
    sca 69-42 hPMS 3.00 gioco 0.40 max 10.2).
    Contenuti: tabelle comparative per fonte con note di attendibilita (fianco
    scansione ~-35%, in indagine; dispersione tra rilievi +/-5 gradi/0.15mm);
    fasatura installata (ICL ~102-104 / ECL ~103.5, overlap 79-85) vs scheda
    (105/105); valutazione della proposta 106/108 per erogazione 4000+ rpm:
    direzione corretta (IVC piu tardi, blowdown anticipato, LSA 107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
2026-07-05 .gitattributes: binari senza conversione EOL (PDF/immagini/xlsm)
    Il PDF del report era stato indicizzato come testo (warning CRLF): a un
    checkout futuro si sarebbe corrotto. Marcati binari i formati binari e
    re-indicizzato il PDF senza conversione.
2026-07-11 Validazione fisica metodo puntalino->bicchiere (Clio + piattello O33)
    Esperimento decisivo: stessa camma Clio 1.8 misurata col puntalino sferico
    (+ conversione matematica a bicchiere O33) e poi con piattello O33 FISICO.
    Protocollo: reset a 180 gradi dal picco prima di OGNI scansione (via encoder,
    errore sempre <=0.75 gradi), 5 scansioni per fase (classica x2, autonoma v3
    x2, mediata c3 x1).
    RISULTATO - METODO VALIDATO:
    - puntalino: picchi 8.52-8.53 (+-0.01mm), sigma/grado 0.025mm, classico ==
    autonomo (RMS 0.055mm)
    - piattello O33 fisico: picchi 8.500, stessa ripetibilita
    - confronto diretta-vs-matematica: miglior accordo a rBase 19mm -> RMS
    0.046mm, max|D| 0.19mm su tutto il profilo; i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
2026-07-11 Export 'Scheda camma' (cam card PDF) in stile rettificatore
    Richiesta utente su modello Cat Cams: dal rilievo col puntalino, generare la
    scheda della camma dichiarando il follower con cui la curva e presentata
    (bicchiere O, rullo, finger con leva, o grezzo + bilanciere).
    exportCamCard() (analisi.html): PDF A4 orizzontale con
    - tabella asp/scarico: gioco, durata @gioco e @riferimento, alzata VALVOLA e
    alzata CAMMA, angolo lobo, apre/chiude, alzata al PMS, overlap, LSA
    - diagramma dei due lobi sui gradi motore (PMI-PMS-PMI, centri annotati,
    livello alzata@PMS, fasatura) su canvas embeddato
    - intestazione con dichiarazione metodo: 'Rilevazione: puntalino R x mm -
    curva presentata come <f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
2026-07-11 Home: bottone 'Svuota archivio' con doppia conferma
    Richiesta utente: eliminare in un colpo tutti i file delle misure vecchie.
    clearArchive() nella toolbar dell'archivio Home:
    - elenca i file via /api/files e chiede DUE conferme esplicite (conteggio
    reale nel testo + avviso di scaricare prima cio che si vuole conservare)
    - elimina tutti i .scr via l'API DELETE esistente (loop sequenziale, report
    dei falliti)
    - ripulisce tag e preferiti dei file eliminati (altre preferenze intatte)
    - toast di esito e refresh lista.
    Verifica browser senza toccare l'archivio reale: bottone presente e cablato,
    percorso ANNULLA -> zero cancellazioni (19 file prima e dopo), testo conferma
    corretto, 0 errori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
2026-07-11 Fix encoder live fuori scansione + pannello Avanzate + msg sensore polare
    Da feedback utente al banco, tre sintomi con una sola radice (BUG):
    currentEncoderCount era aggiornato SOLO dalle misure di scansione, mai dalle
    risposte 'encoder=N deg=' del polling '?'. Fuori scansione restava null ->
    meccanismo live fermo a 'cam 0', traccia live vuota in free-spin, 'Salva pos'
    che chiedeva all'infinito di aspettare il polling. Fix: parse del conteggio
    nel ramo polling. VERIFICATO AL BANCO: encoder popolato dal polling idle,
    comando +5 gradi -> angolo live aggiornato, Salva pos sbloccato.
    Razionalizzazione controlli scansione (dati test 07-05/07-11: classico ==
    autonomo == mediato entro 0.05-0.07mm)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
2026-07-11 Semplificazione UI data-driven + update software/firmware da remoto (v3.1.0)
    Test al banco delle 6 modalità (Clio+Ø33): fast≡std≡race≡ultra entro
    0,05mm RMS; Hyper/Atomic chiedevano r4/r1 che il firmware rifiuta
    (min r8) → erano rotte by design. Modalità ridotte 6→3 (Veloce/
    Precisione/Race, tempi misurati).
    - Alzata: rimossa "Sorgente angolo" (passi≡encoder al banco), sav()
    semplificato; Motore scansione default=Firmware (validato), Browser
    come fallback compatibilità
    - Polare pensionata → legacy/; vista polare in Confronto dai file _alz
    (raggio base + alzata), _pol legacy ancora leggibili
    - Update-check in-app: GET /api/update-check (GitHub Releases, cache
    1h) +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
    [full_scan_2026-05-03.csv]
2026-07-11 Revisione QA: scheda camma PDF, tour guidato, tooltip (audit verificato)
    Scheda camma: fix sovrapposizione remarks (wrap con avanzamento per
    riga), carattere '->' al posto di '→' (WinAnsi), asse diagramma
    allineato a PMS=360 (tick -240…0…240), follower/baseline dichiarati
    dallo snapshot dell'analisi e non dal DOM, picchi camma congelati in
    lastAnalysis, troncamento nomi file, clamp etichette lobo. Verificato
    rigenerando il PDF reale e ispezionandolo renderizzato.
    Tour: step per card Sistema&aggiornamenti (Home) e ⚙ Avanzate
    (Alzata); step Compliance/Surge (invisibili coi moduli off) accorpati
    in ⚙ Funzioni; warn in console per step con target nascosto.
    Tooltip: Concerto 4→7 bra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
2026-07-12 Robustezza officina + assistenza remota (punti 2-11, testati live)
    - Backup ZIP reale: /api/backup-zip (ZIP stored fatto a mano, no deps)
    + bottone Home; il MANUALE ora dice il vero. Verificato con unzip.
    - Salvataggio Alzata con ACK dal server (POST /api/file) + guardia
    sovrascrittura con conferma; prima l'invio WS era fire-and-forget.
    - Doppio avvio: banner "CAMMES è già in esecuzione" + uscita in 8s
    invece dell'istanza zombie (handler EADDRINUSE su HTTP e WS).
    - Log su file (cammes.log, rotazione 1MB) + /api/diagnostics +
    bottone Diagnostica in Home per l'assistenza.
    - Versione firmware REALE sull'Arduino: probe 'v' a ogni apertura
    seriale, esposta in /api/firmware-info e nell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
2026-07-12 Piano completo v3.2: sicurezza banco, collaudo PASS/FAIL, exe unico, cestino (fw 3.1)
    - App Android ELIMINATA (ferma alla v1, fuorviante)
    - Exe UNICO autosufficiente: serialport dentro l'exe (pkg assets +
    estrazione di riserva). VERIFICATO: exe eseguito in cartella vergine
    → driver caricati, COM8 trovata. CI: anche cammes-completo.zip.
    Banner rosso in Home se driver assenti.
    - Firmware 3.1: STOP di emergenza reale — stepperMove interrompibile
    ('x' → *mabort). Testato al banco: 200° comandati fermati a ~100°,
    *mabort +362ms via server (bug del peek accecato dal polling trovato
    e corretto sul ferro). Flashato via endpoint in-app.
    - Allarme slittamento anche nello scan auton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
    [master.ino]
2026-07-12 Guardie sensore: pre-flight, auto-stop su letture invalide, toast transizioni
    Bug trovato dall'utente al banco: scansione avviata senza comparatore
    proseguiva fino in fondo. Causa: il pin flottante del LM339N produce
    numeri casuali (spesso fuori scala) che azzeravano il contatore NaN e
    rinfrescavano il timestamp "sensore ok".
    - start(): pre-flight — senza misura valida recente non si parte
    - "valido" = numerico E in scala 0-32mm (spazzatura = guasto)
    - auto-stop dopo 3 letture invalide consecutive, toast err esplicito
    "misura NON valida" + stop firmware (x)
    - toast su perdita/ritrovamento comparatore (prima solo colore LED)
    - manuale aggiornato
    Tutto verificato live: pre-flight blocca,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
2026-07-12 Encoder scollegato in scansione: messaggio dedicato, recovery, LED veritiero
    Precisazione dell'utente: il test era con l'encoder staccato, non il
    comparatore. Tre gap corretti:
    - conteggi esattamente fermi ora danno "Encoder scollegato o fermo"
    (con spiegazione: misura valida sui passi, ma niente zero virtuale
    né allarme slittamento) invece del fuorviante "slittamento stepper"
    - il caso fermo non è latchato: al ricollegamento a scansione in corso
    compare "Encoder di nuovo attivo"
    - LED encoder alimentato anche dai dati di scansione (prima ingialliva
    sempre durante le misure) e ROSSO quando i conteggi sono immobili
    Verificato live: fermo → toast err + LED rosso; in moto → toast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
2026-07-12 Barra di stato a 4 LED: Comparatore, Motore, Encoder, Server
    - Comparatore (ex Sensore, rinominato ovunque): verde/giallo/rosso
    come prima ma con legenda al passaggio del mouse
    - Motore (nuovo): verde pronto, BLU LAMPEGGIANTE in movimento (scan,
    zero virtuale e rotazioni manuali), giallo sbloccato, rosso Arduino
    muto; il blu si spegne all'arrivo di *mv/*mabort
    - Encoder: alimentato anche dallo streaming di scansione, rosso a
    conteggi fermi
    - Tooltip-legenda su ogni LED, manuale aggiornato, classe CSS .led.run
    Verificato live tutti gli stati, inclusa rotazione reale di 45°
    (verde -> blu -> verde al *mv).
2026-07-13 Profili movimento: 4->1 dopo test banco; motore scansione automatico; layout
    - Test al banco k0/k1/k2/k3 (Clio, scansione Veloce completa ciascuno):
    stessa curva entro la ripetibilita' (RMS 0,06-0,08mm vs Standard),
    tempi 46-57s. Selettore Profilo ELIMINATO, fisso Standard k1.
    - Selettore Motore scansione ELIMINATO: sempre scan autonomo firmware;
    su firmware pre-v3 fallback AUTOMATICO al metodo classico con
    riavvio della scansione e suggerimento aggiornamento.
    - Layout Analisi: "Funzioni (N attive)"->"(N)" + header flex-wrap
    (Base/Avanzato usciva dalla card con 5 moduli attivi); Preset motore
    non tocca piu' il bordo.
    - Layout Alzata: pannello Avanzate a tutta larghezza sotto la t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
2026-07-13 Firmware 3.2: fix overflow rotazioni lunghe (scoperto dal test profili a bassa velocita')
    Test rotazioni continue 180 gradi a/r per k0..k3 (domanda utente sulla
    velocita' inferiore): stesso angolo percorso per tutti (coerenza encoder
    0,05%), zero passi persi anche a velocita' massima, cambia solo il tempo
    (6/9/14/20s) -> confermato profilo fisso Standard.
    Il test ha scovato un bug reale: contatore passi uint16 in stepperMove,
    overflow oltre ~2047 gradi in un colpo (mai colpito dall'UI, max 360).
    Fix: uint32. Flashato e verificato al banco: $+3000 -> 2999,5 gradi
    misurati dall'encoder (0,017%), ritorno netto -1 cnt.
    [master.ino]
2026-07-13 Firmware 3.3: audit stabilita' comparatore (*sstat) + misura tempi al banco
    Domanda utente: "il comparatore ha tempo di assestarsi a tutte le
    velocita'?" Risposta misurata: su 360 punti reali l'assestamento
    (2 frame concordi entro 5um) richiede 161-328ms contro un budget di
    1500ms -> margine 4,6x anche sul punto peggiore.
    Chiuso il buco residuo: a budget scaduto il punto veniva accettato in
    silenzio. Ora il firmware dichiara a fine scansione quanti punti non
    si sono stabilizzati (*sstat u=N); la UI avvisa se N>0 e lo scrive
    nei metadati del file (#puntiInstabili). Verificato sul ferro:
    scansione completa -> *sstat u=0.
2026-07-13 Esperimento anti-falsa-stabilita': il criterio 2-frame regge (limite = 1 tacca)
    90 punti da 1 grado con lettura completa dei frame per 2,6s dopo ogni
    passo: il valore accettato dal criterio '2 frame concordi entro 5um'
    coincide con la verita' a 2,6s (mediana 0, max 0,010mm = 1 tacca del
    centesimale, 2 punti su 90). Frame rate reale del Neoteck ~10Hz.
    Un ritardo di assestamento da ~1s e' escluso sperimentalmente.
    Fenomeno flicker di quantizzazione documentato nel CHANGELOG,
    nessuna modifica al firmware necessaria.
2026-07-14 Alzata: valori gauge centrati, meccanismo live centrato, via il doppione valvola
    Segnalazioni utente sulla videata Alzata:
    - il numero rosso (mm) e i gradi verdi erano scritti con spazi di
    riempimento stile 2014 (" 00.00", " gradi 0") che li spostavano
    dal centro delle caselle -> valori puliti, il text-align:center
    ora centra davvero
    - il canvas del Meccanismo live e' display:block e non si centrava
    col text-align del contenitore -> margin:0 auto (29px esatti/lato)
    - il readout dell'animazione mostrava "alzata" e "valvola" SEMPRE
    identici nella vista live (puntalino 1:1): la riga valvola ora
    compare solo quando differisce davvero (bilanciere/follower attivi,
    come in Analisi)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
2026-07-14 Audit L1: MAT-01 centri frazionari, MET-01 invalidi non azzerati, MET-02 verifica banco senza falso PASS
    - mapCamToCrank: mappatura inversa + interpolazione circolare (centro 106,5°
    prima azzerava la curva in silenzio; ora picco preservato a 0,001 mm)
    - benchVerdict in lib (testato): buchi/NaN/fuori scala -> NON VALUTABILE,
    mai PASS con dati mancanti; toast 'salvato' solo se il server risponde ok
    - letture invalide scartate dal profilo (prima: zero fisico), run incompleti
    dichiarati a fine giro, #stato=INCOMPLETO/#gradiMancanti nel .scr,
    avviso all'import in Analisi; parseCamFile: validCount=gradi UNICI (MAT-07)
    + missingCount/covered
    - nuovo tools/test_misura_affidabile.js in npm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
2026-07-14 Audit L2: MAT-02 fase dal picco misurato, MAT-03 segni=etichette, MAT-04 anticipo applicato (+MAT-05 centri reali)
    - mapCamToCrank: fase agganciata al picco misurato sub-grado (camPeakPos,
    fit parabolico) -> lo zero di scansione non sposta piu' la curva mappata
    - convenzione = etichette UI: aspirazione picco a 360+centro (ATDC),
    scarico a 360-centro (BTDC); prima erano invertiti (252/472 vs 468/248)
    e la cam card metteva le etichette sui lobi opposti
    - effectiveCenters(int,exh,adv): anticipo nei centri effettivi, applicato
    in analyze() e agli import; alzata@PMS = campione a indice 360 della
    curva fasata (fianco fisicamente giusto per lobo, scarico in chiusura)
    - eventi/LSA dai cent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
2026-07-14 Audit L3: firmware 3.4 (watchdog host, Concerto interrompibile, 'x' idle) + timer scansione cancellati da STOP
    - MOT-01: registro _scanTimers + generation token; stop() cancella riavvio
    run ripetuto (1,5s) e fallback firmware (6s/800ms) e azzera autoScanActive
    -> il motore non puo' piu' ripartire da solo dopo STOP (verificato live)
    - FW-02: loop Concerto controlla 'x' ogni 16 passi (*tabort); il drain di
    fine nota non ingoia piu' uno STOP ritardatario
    - FW-03: watchdog host durante i movimenti (stepperMove/scan/tone): nessun
    byte per 5s -> *wdt+abort; il keep-alive '\n' ogni 100ms del server copre
    l'esercizio normale con margine 50x; rollover-safe
    - fix scoperto in verifica: 'x' a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
    [master.ino]
2026-07-15 Audit L4: confine di rete — allowlist statica (SEC-02), Host/Origin (SEC-01), prove/ fuori dall'exe
    - statico ad ALLOWLIST: solo pagine UI, css/js, lib/, fonts/, images/;
    cammes.log (608KB di attivita'), settings.json, prove/*.scr, sorgente
    server, node_modules e fw/ ora rispondono 404 anche se esistono
    - anti DNS-rebinding: Host esterni -> 403 su HTTP e WS (localhost, IP
    letterali e hostname macchina restano ok: uso multi-dispositivo LAN
    INVARIATO, nessun bind su loopback)
    - WebSocket verifyClient: Origin di siti terzi rifiutata (una pagina web
    qualsiasi poteva comandare il motore: niente same-origin sui WS);
    client non-browser (tool da banco) sempre ammessi
    - pkg.assets: rimo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
2026-07-15 Audit L5: interblocchi scansione (MOT-02), socket unico (MOT-03), STOP Concerto reale, RESET sicuro (MOT-05)
    - _scanBusy(): START doppio, jog m1/p1, Ruota, direzione, Zero virtuale,
    FREE, reset encoder e posizioni salvate BLOCCATI durante la misura
    (verificato live: zero byte al motore con scansione attiva)
    - socket unico: sendSocket = engineSocket (lifecycle completo + reconnect);
    prima il socket di solo invio senza onclose/onerror poteva morire da solo
    -> STOP no-op con toast 'interrotta' bugiardo, e ogni riconnessione ne
    creava un altro (leak)
    - WS_URL segue location.hostname (da tablet in LAN puntava al tablet)
    - stopHomeConcert invia 'x' reale (fw 3.4 ferma la nota con *tabort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
2026-07-15 Audit L6: P1 rapidi — ws 8.21, MAT-07/08, DOC-01, ESLint, pulizie
    - ws ^8.16 -> ^8.21 (npm audit: risolti GHSA-58qx e GHSA-96hv); resta solo
    l'advisory di pkg (devDep, nessun fix a monte)
    - MAT-08: reindexByEncoder con soglia RELATIVA (>=70% del giro atteso):
    mezzo giro encoder non passa piu' per giro completo (+2 test)
    - MAT-07: parseCamFile gia' a gradi unici dal L1 (validCount/missingCount)
    - DOC-01: README a firmware 3.4 (era 3.1) + watchdog e STOP Concerto
    - APP-18: rimosso residuo </content></invoke> in fondo a style.css
    - APP-19: testo eliminazione allineato al cestino 30 giorni (non 'irreversibile')
    - ESLint 9 installato: 'npm run lint' verde (0 errori); lib/cammes-math.js
    or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
2026-07-15 Audit L7: valve float = perdita di contatto reale (DYN-01) + camma interpolata (DYN-03) + default nullish (DYN-04)
    - detectValveFloat ora misura la SEPARAZIONE cam-punteria tracciata dentro
    il solver (follower sopra la camma), non piu' max(cam-valvola): quello
    misurava lo schiacciamento elastico (~0,24mm anche a 1 rpm) e DECRESCEVA
    coi giri. Ora float = 0 al quasi-statico, cresce coi giri, cala se la
    molla e' piu' rigida (verificato su camma Clio reale)
    - simulateCompliance/2DOF/3DOF espongono .maxSeparation e .floatIdx
    - camAt interpolato linearmente in tutti e 3 i solver (DYN-03: prima
    nearest-neighbor a 1°, gradini spuri sul fianco)
    - DYN-04: parametri con nullish (_num) invece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
2026-07-17 Banco: fw 3.4 flashato e VALIDATO (16/16) + harness hardware + scan Clio end-to-end RMS 0,047
    - tools/bench_fw34_test.js: harness HIL riutilizzabile (kick anti-trappola
    FTDI, watchdog provato in finestra muta con verifica indiretta encoder)
    - watchdog: moto troncato a 1373/4000° (~5,5s), motore fermo, fw vivo
    - *tabort 126ms, cmdBuf pulito dopo x idle, STOP classico 186ms
    - scan Veloce Clio: 360/360, 0 invalide, 0 instabili, RMS 0,047mm vs storico
    convertito puntalino->piattello Ø33 (conferma anche la matematica follower)
    - STOP a meta' scansione: nessun riavvio spontaneo (MOT-01 live)
    - nota MET-03 confermata sul campo: il .scr non registra il tastatore ->
    il confronto grezzo puntal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
2026-07-17 Lotto 8 (MET-03/MET-04): provenienza completa nel .scr + avvisi incoerenza in Analisi
    - metadati nuovi al salvataggio: #tastatore (selettore in Avanzate,
    ricordato tra sessioni), #verso (orario/antiorario), #microstep,
    #fw (versione REALE dall'Arduino via /api/firmware-info),
    #encoderSpan (corsa encoder netta del giro, ~±1440 = giro pieno)
    - Analisi: avvisi se aspirazione e scarico dichiarano verso o tastatore
    diversi (fianchi specchiati / rampe non confrontabili)
    - motivato dal banco: puntalino vs piattello Ø33 sullo stesso lobo =
    1,26mm RMS apparenti; convertito = 0,047mm. Ora il file lo dice da solo.
    - validato al banco: scan 360/360, .scr con tutti i metadati, ripetibilita'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
2026-07-17 Lotto 9 (FW-04/FW-05): firmware 3.5 — parser strtol+range, stabilita' sensore; validato al banco 23/23
    - FW-04: parser S/$ con strtol 32bit + grammatica/range espliciti. Prima
    atoi int16 wrappava: S+70000 -> 4464 unita' ESEGUITE in silenzio. Ora
    fuori grammatica/tetto (S<=1500, $<=3600) -> *err e ZERO moto.
    - FW-05: readSensorStableMm — un frame NaN azzera il confronto (due letture
    concordi separate da un buco non passano piu' per stabili); <2 frame validi
    nel budget -> NaN vero (scartato dal browser via MET-01)
    - fw 3.5 compilato (10260 byte), flashato, harness 23/23 PASS (nuovo blocco G:
    5 comandi malformati -> *err, encoder immobile, comando legittimo dopo ok)
    - 3 scansioni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
2026-07-17 Lotto 11 (SER-02/SER-03): flash firmware robusto — once-guard + porta verificata
    - SER-02: runAvrdude con guardia 'settled'. spawn emette error POI close su
    fallimento avvio -> avrdudeDone chiamato 2x -> doppio sendJson (headers
    already sent, crash) e doppio reset flashInProgress. Ora vince il primo
    evento; anche il timeout 90s chiude pulito.
    - SER-03: se la seriale non e' aperta, prima del flash si verifica che la
    porta (da lastComPort, stale dopo replug su altra COM) sia ancora nell'
    elenco; altrimenti 409 con le porte disponibili invece di flashare il
    device sbagliato. Con seriale aperta usa serialPort.path (autorevole).
    - validato al banco: flash via API -> singola risposta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
2026-07-17 Lotto 12 (SEC-05/SEC-06): robustezza richieste + scritture atomiche
    SEC-05:
    - ogni richiesta in try/catch (handleRequest): un handler che lancia ora da'
    500 pulito invece di appendere il socket via uncaughtException
    - decodeURIComponent protetto (URL/nome file con % malformato -> 400)
    - readBody() con limite che risponde 413 esplicito su settings/save/restore
    (prima req.destroy() muto: il client vedeva solo la connessione interrotta)
    - validazione: patch settings deve essere un oggetto (no array/scalari)
    SEC-06:
    - writeFileAtomic (temp+fsync+rename): un crash a meta' scrittura non puo'
    piu' troncare settings.json (rename atomico: vecchia o nuova, mai a meta')
    - coda _settingsQueue: PO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
2026-07-17 Lotto 13 (APP-08/APP-09): loader Confronto robusto via parseCamFile
    - grafici.html instrada loadFile/showResult, vista polare e nominale su
    parseCamFile (libreria inclusa): stop allo split posizionale fragile
    (riga i = grado i), al limite 361 che ora beccava la coda #metadati, ai
    crash su file corti e a vmax1.split('.')
    - anti-contaminazione: ogni slot 1..4 ha il PROPRIO array (_cmpData/_polData)
    invece del globale condiviso valori/valori5 -> un file piu' corto non
    eredita piu' la coda del precedente (verificato: slot2@300 = 0, non 5)
    - guardia APP-09: validCount<30 -> file rifiutato; avviso su misure incomplete
    - ramo _pol legacy preservato; limite 360 ovunque
    - validato dal vivo: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
2026-07-17 Lotto 14 (APP-01/APP-02): staleness analisi + dispatcher modello compliance
    APP-02: runComplianceModel dispatcher unico — sweep RPM, suggerisci molla,
    mappa k×F0 e sweep 3D ora rispettano il modello 1/2/3-DOF selezionato (prima
    forzavano sempre 1-DOF); arricchisce i parametri bilancere/sede dal DOM.
    Verificato: a 12000rpm float 5.60/12.20/12.18mm per 1/2/3-DOF.
    APP-01: guardia stale-ness. Cambiare un parametro che modifica la CURVA
    (follower, rBase, rocker, centro, anticipo, gioco, smoothing, modello/param
    compliance) senza ri-premere Analizza -> banner + export CSV/PDF/cam card/
    race report bloccati con avviso; il live tuning con compliance attiva marca
    stale (forze live ma valve-float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
2026-07-17 Lotto 15 (APP-03..07): esplorazione molla, doughnut fasatura reale, durata@gioco, A/B pipeline, provenienza per-lato
    - APP-03: ottimizzatore molla -> ESPLORAZIONE (solo valve float): bottone,
    titoli, toast e PDF riformulati, caveat esplicito (no coil bind/stress/
    fatica/geometria), margine alla soglia mostrato
    - APP-04: updateTimingDiagram posiziona gli eventi agli angoli di manovella
    REALI (2 anelli concentrici, archi centrati sul lobo, origine al PMS di
    scoppio = valvole chiuse, niente troncamento), overlap dal valore reale
    - APP-05: durata@gioco con soglia FISSA dichiarata (DUR_EPS 0,05mm; il gioco
    e' gia' sottratto nella curva) invece di max(0,05, 1% picco) adattivo;
    soglia e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
2026-07-17 Lotto 16 (MET-05): posizioni encoder legate all'epoca dello zero
    - posizioni salvate timbrate con currentEncEpoch() (sessionStorage)
    - reset encoder '!' e reboot Arduino incrementano l'epoca
    - gotoSavedPosition rifiuta una posizione di epoca diversa (prima ci
    sarebbe andato con un riferimento zero sbagliato); chip barrato
    - lo zero virtuale NON incrementa l'epoca (sposta l'albero senza
    azzerare il contatore encoder)
    - verificato live: valida prima del reset, rifiutata dopo. Suite 135, lint 0.
2026-07-17 Lotto 17 (FW-01/06/11/12): firmware 3.6 — FREE persistente, p/q assestato, boot handshake, pin order
    - FW-01: FREE è uno STATO persistente (g_motorFree). I movimenti sono
    rifiutati con *locked finché non arriva 'l' (LOCK). Prima p/q/$/S
    rimettevano ENA=HIGH e muovevano con la mano ancora sull'albero.
    - FW-06: p/q leggono con settle meccanico (cfgSettleMs) + lettura adattiva
    a 2 frame (readSensorStableMm), come lo scan autonomo. Prima: un frame
    subito dopo il movimento, con le vibrazioni in corso.
    - FW-11: handshake di boot versionato '*boot ver=3.6 r/samp/settle/free/rst'
    con reset reason (MCUSR letto e azzerato); 'CAMMES Uno ready' invariato
    (l'host lo usa per rilevare i reb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
    [master.ino]
2026-07-17 Lotto 18 (SEC-04/07/08/10): hardening server
    - SEC-04: containment con path.relative (isInside) — il confronto a prefisso
    accettava le directory sorelle (/x/prove vs /x/prove-altro)
    - SEC-08: logging asincrono a coda (batch 200ms + rotazione async) invece di
    appendFileSync per ogni riga nel percorso caldo seriale
    - SEC-07: backup ZIP con MANIFEST.txt (sha256 per file) + settings.json;
    prima erano solo le misure, senza verificabilita'
    - SEC-10: l'app non scarica ne' esegue nulla in automatico; la notifica di
    aggiornamento ora mostra lo SHA-256 atteso (dalle note release) + comando
    certutil per verificare il download manuale
    - test_server_robustezza esteso (SEC-07: manifest+setting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
2026-07-17 Lotto 19-20 (DYN-02/06/07 + APP-10..17/20): warm-up solver, caveat dinamica, rifiniture UI
    - DYN-02: solver 1/2/3-DOF con warm-up 3 giri (stato riportato tra i giri,
    registra solo l'ultimo) invece di misurare il transitorio dal fermo;
    warmupCycles configurabile. Test dinamici tutti verdi.
    - DYN-06: surge dichiarato esplorativo/euristico (commento lib + tooltip)
    - DYN-07: dominio conversione follower qualificato (RMS 0,046 solo bicchiere
    Ø33 Clio, risoluzione 1° camma). DYN-08 e APP-16 gia' risolti.
    - APP-10: differenziale Confronto esclude le bande nominali (solo misure 0-3)
    - APP-11: vista polare -> type radar = contorno reale (non piu' disco pieno)
    - APP-12: layout responsive via c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
2026-07-17 Lotto 21 (MAT-06/SER-01/FW-08/FW-10/DOC-02): residui software + stato finale audit
    - MAT-06: gia' risolto in L2 (alzata al PMS = curva fasata a indice 360)
    - SER-01: autodetect seriale prova la firma 'v' su OGNI porta (manufacturer
    noti per primi) e tiene solo chi risponde CAMMES; prima apriva il primo
    FTDI/Arduino/WCH senza verificare
    - FW-10: attesa sensore rollover-safe (diff unsigned invece di millis()<deadline)
    - FW-08/DOC-02: README a fw 3.6, protocollo completo versionato in master.ino,
    claim qualificati (validazione di plausibilita', non certificazione; non e'
    un banco a motore); conteggio suite reale (13 suite / 137 check)
    - hex fw 3.6 rigenerato (include FW-10)
    - AUDIT_RESP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
2026-07-18 gitignore DIST_v3.3.0 (artefatto di distribuzione, non in repo)
2026-07-18 Lotto C (1/2): regressione MET-01 run ripetuti + parser rigoroso + APP-09
    Controrevisione Codex — bug di correttezza confermati sul codice v3.3.0:
    - MET-01 REGRESSIONE: _showRepeatedRunsStats faceva count>0?mean:0, un grado
    mancante in TUTTI i run diventava 0 fisico nel profilo salvato. Ora usa
    averageRuns (lib, testato): grado senza campioni validi resta INVALIDO
    (undefined in pdata, null nel grafico), il blocco completamento lo conta e
    sav() marca #stato=INCOMPLETO. Niente zero-fill.
    - parseCamFile rigoroso: duplicati NON sovrascrivono in silenzio (primo vince,
    duplicateDegrees), frazionari segnalati e scartati (fractionalDegrees, non
    arrotondati), invalidRows/outOfRangeRows,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
2026-07-18 Lotto C (2/2) MET-05: epoca zero encoder in localStorage (non sessionStorage)
    Controrevisione: l'epoca stava in sessionStorage -> a un riavvio del browser
    tornava a 0 e una posizione vecchia (epoca 0) ridiventava 'valida'. Ora in
    localStorage, stesso ciclo di vita delle posizioni; l'Arduino non si resetta
    alla riconnessione del browser (solo all'apertura porta lato server, che gia'
    bumpa l'epoca). Residuo documentato: 'server riavviato a browser chiuso'
    richiede device/boot-id firmware (Lotto B).
2026-07-18 Lotto D: eventi da crossing reali (MAT-03) + naso piatto (MAT-02) + MATH_SPEC
    - findEvents(crank, soglia): apertura/chiusura dagli ATTRAVERSAMENTI reali
    della curva fasata, interpolati sub-grado, con wrap 720->1. Sostituisce
    centro±durata/2 (che assume simmetria e su lobi asimmetrici sbaglia ~60°).
    analisi.html usa inEv/exEv per openBTC/closeABC/openBBC/closeATC/overlap/
    durata; convenzioni invariate su lobo simmetrico. Verificato su Clio reale:
    eventi auto-coerenti (durata = open+180+close).
    - camPeakPos: naso PIATTO -> centro circolare del plateau (prima il primo
    massimo: plateau 170..190 dava 170.5, ora 180); picco netto invariato.
    - MATH_SPEC.md: convenzioni, ordine pipelin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
2026-07-18 Lotto E: convergenza periodica dei solver compliance (DYN-02) + non-convergente segnalato
    - simulateCompliance 1/2/3-DOF: il warm-up a 3 cicli FISSI diventa un loop di
    convergenza (fino a maxCycles=30): confronta lo stato di fine giro N con N-1;
    due giri identici entro tol -> CONVERGED, out.converged/cyclesRun esposti. Il
    caso estremo del documento (molla 1 N/mm, damping 0.001, 12000 rpm) ora dà
    converged=false a 30 cicli invece di un numero 'sicuro' a 3.
    - analyze(): un modello NON convergente -> toast 'Compliance NON convergente'
    e window._complianceConverged=false (float/regime inaffidabili).
    - input zero (DYN-04) gia' via _num nullish: verificato (damping 0 / F0 0
    diversi da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
2026-07-18 Lotto F/G (parziale): header sicurezza anti-clickjacking + salva.bat robusto
    - Lotto F: header di sicurezza su ogni risposta HTTP — CSP frame-ancestors
    'none', X-Frame-Options DENY, X-Content-Type-Options nosniff,
    Referrer-Policy no-referrer, Permissions-Policy. Anti-clickjacking senza
    rompere le pagine (CSP default-src 'self' resta PARTIAL: serve spostare gli
    script inline in file). Test in test_server_robustezza (secEight).
    - REL-08 salva.bat: 'if errorlevel 1' a runtime (prima '%errorlevel%' dentro
    il blocco if veniva espanso al parse e annunciava successo su push fallito);
    staging selettivo che esclude prove/settings/log/dist/exe come cintura oltre
    al .gitignore; 'niente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
2026-07-18 Deliverable A/B/G (design+doc): MOTION_CONTROL_MODEL, PROTOCOL, THIRD_PARTY_NOTICES, RELEASE_MANIFEST
    Documenti mandati dalla controrevisione 'prima di implementare':
    - MOTION_CONTROL_MODEL.md: design Lotto A (lease, FSM server, STOP/ACK,
    FREE/LOCK, flash) + stato attuale vs target; latenze = NEEDS_HARDWARE.
    - PROTOCOL.md: protocollo v3 attuale (fw 3.6) documentato + design v4
    (runId/seq, ACK/NACK/EVT, HELLO/STATUS con device id, heartbeat dedicato,
    fault latched). Migrazione v4 = coordinata fw+server+UI, da validare al banco.
    - THIRD_PARTY_NOTICES.md: inventario dipendenze/asset/licenze (jsPDF e pkg
    advisory, responsivevoice da rimuovere).
    - RELEASE_MANIFEST.json: versione/commit/ha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
2026-07-19 bench harness: rilevazione *wdt robusta al buffering FTDI (in coda o durante il silenzio)
    Su alcuni FTDI la riga *wdt arriva durante la finestra muta del test watchdog
    invece che al kick successivo. Il watchdog funziona (arriva *mabort, moto
    troncato): era solo la detection del test. Ora sawBetween || waitFor.
2026-07-19 Lotto A (MOT-04/MOT-03): controller lease + STOP su perdita controllore [validato al banco remoto]
    - Server = autorita' unica: un solo client 'controllore' (il primo che invia
    un comando di moto); gli altri sono OSSERVATORI read-only (i loro comandi
    di moto sono rifiutati, #ctl:denied). STOP ('x') consentito a CHIUNQUE.
    - Vitalita' del controllore via ping/pong WebSocket (a livello protocollo,
    robusto al throttling dei tab in background) + on-close: alla perdita del
    controllore releaseLease() scrive 'x' sulla seriale -> il moto si ferma
    (MOT-03: il keep-alive del server non maschera piu' la perdita).
    - alzata.html: gestione #ctl: (observer -> banner sola lettura, denied ->
    toast)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
2026-07-19 Lotto B (FW-04/FW-09): parser config rigoroso + NACK busy [fw 3.7, software-validato]
    Firmware 3.7 (incrementale, non-breaking, retrocompatibile con server/UI 3.3.x):
    - FW-04: comandi di configurazione c/r/w/u/a/g/k ora usano parseIntStrict
    (strtol + range espliciti) al posto di atoi, che accettava spazzatura in
    coda ("c3xyz"->3) e overflowava in silenzio. Input non valido -> "*err <c>",
    nessuna modifica.
    - FW-04: overflow di riga -> scarto fino a fine riga + "*err ovf". Prima si
    azzerava solo cmdLen e il frammento residuo formava un comando spurio.
    - FW-09: comando "vero" arrivato durante un movimento/scan -> NACK "*busy"
    (una volta per operazione). Prima veniva scartato in silenz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
2026-07-19 Lotto G (REL-07/REL-10): build firmware riproducibile + SBOM CycloneDX
    REL-07 — riproducibilità sorgente→HEX DIMOSTRATA:
    - Il firmware compila bit-per-bit identico con core pinnato arduino:avr@1.8.7:
    due build locali indipendenti + HEX committato + version.json convergono
    tutti su SHA256 2ae84e28… (avr-gcc 7.3.0-atmel3.6.1-arduino7, deterministico).
    - tools/verify_firmware.js: livello 1 (in npm test) confronta HEX committato vs
    version.json.hexSha256 (niente toolchain, intercetta drift HEX/descrittore);
    livello 2 (--compile) ricompila e verifica lo stesso SHA.
    - .github/workflows/firmware.yml (windows-latest, stesso host della release):
    installa il core pinnato, ricompila, c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
2026-07-19 REL-07: confermato run CI verde su GitHub (riproducibilità HEX dimostrata)
    Il job reproducible-hex di firmware.yml e' passato su windows-latest (43s):
    ricompilato master.ino con arduino:avr@1.8.7 e ottenuto lo stesso SHA256 di
    version.json. REL-07 passa da "build deterministica dimostrata (localmente)"
    a "riproducibilita' dimostrata in CI".
2026-07-19 Lotto F (SEC-08): limiti WebSocket — maxPayload + rate limiting anti-flood
    - maxPayload 1 MB sul WebSocket.Server: un messaggio oltre il tetto fa chiudere
    la connessione (code 1009) invece di allocare memoria senza limiti. I comandi
    sono di pochi byte, i salvataggi file al piu' decine di KB: 1 MB e' margine ampio.
    - Rate limiter a finestra fissa 1 s, 60 msg/s per connessione (refill pigro,
    nessun timer). Oltre la soglia i messaggi in eccesso sono scartati con un solo
    warning per finestra. Lo STOP 'x' passa SEMPRE (sicurezza), anche sotto flood.
    - test_server_robustezza.js: nuova sezione SEC-08 con client ws reale — messaggio
    >1MB -> close 1009; raffica 120 acquire in una finest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
2026-07-19 fw 3.7 FLASHATO e VALIDATO al banco (COM5): FW-04/FW-09 → VERIFIED
    bench_fw34_test.js su COM5 (DESKTOP-PN6EEA8, 2026-07-19): 38/38 verdi, inclusa
    la sezione J sull'hardware reale:
    - boot *boot ver=3.7; risposta 'v' = ver=3.7 scan=1 proto=3 free=0
    - FW-04: c99/c3xyz -> *err c; r20 -> *err r; c3 -> *cfg; riga troppo lunga ->
    *err ovf senza moto spurio (encoder immobile)
    - FW-09: comando durante $ -> *busy, il moto prosegue fino a *mv
    Confermate anche tutte le protezioni preesistenti (wdt, *tabort, cmdBuf, STOP,
    parser S/$, FREE persistente *locked).
    version.json: sourceCommit=aa2f812 + campo benchValidated. REMAINING_RISKS:
    FW-04 e FW-09 a VERIFIED. Flash: avrdude -c arduino -b 115200, 11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
2026-07-19 Lotto B (FW-03): fault locale encoder nello scan [fw 3.8, validato al banco]
    Colma il buco: il motore gira in anello aperto; con encoder scollegato/rotto o
    albero bloccato il browser userebbe uno "zero virtuale" sbagliato senza
    accorgersene.
    Caratterizzazione al banco (COM5, nuovo albero, r32): ~4,00 counts/unità,
    spread 1,1% (3,978-4,022), backlash 2 counts su ±360 → dato pulito che tara la
    soglia senza rischio di falsi allarmi. Strumento riusabile: tools/bench_encoder_char.js.
    Firmware (autonomousScan): ogni 30 unità verifica che l'encoder sia avanzato di
    ~cfgStepsPerUnit/8 counts/unità. Soglia = 1/4 dell'atteso (min 3 counts) →
    margine 4× sul sano. Encoder ~fermo mentre il moto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
    [master.ino]
2026-07-19 Lotto B (FW-08/11, MOT-02): protocollo v4 additivo [fw 4.0, validato al banco]
    Protocollo seriale versionato v4, ADDITIVO e negoziato — v3 resta byte-identico
    e pienamente funzionante (la UI continua a usarlo). Una riga che inizia per
    CIFRA e' v4 ("<seq> VERBO args"); v3 non ne ha → discriminazione netta.
    Firmware (fw 4.0):
    - FSM esplicita: BOOT/FREE/IDLE_LOCKED/MOVING/SCANNING/TONE/STOPPING/FAULT,
    unica fonte di stato aggiornata da comandi v3 e v4; g_runId sceglie il formato
    di emissione delle primitive di moto condivise (v3 *mabort/#i:enc:mm vs v4 EVT).
    - Verbi: STATUS→HELLO, HEARTBEAT (dedicato), LOCK/FREE, CONFIG, SCAN/MOVE,
    RESET_FAULT, STOP. ACK/NACK correlati per seq; EVT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
    [master.ino]
2026-07-20 Fase 2 v4 (MOT-02): bridge server↔v4 del data-path di scan [validato al banco]
    Con firmware v4 (proto>=4) il SERVER diventa l'autorità del data-path di scan,
    mantenendo la UI INVARIATA (zero rischio sul flusso di misura funzionante):
    - WS→seriale: lo scan-start della UI "S±N" (v3) è tradotto in "<seq> SCAN
    run=R dir=± units=N" (v4 correlato).
    - seriale→WS: gli EVT v4 sono ritradotti nel formato v3 che la UI già capisce:
    EVT SAMPLE→"#idx:enc:mm", EVT DONE→"*sstat u=U"+"*sdone", EVT STOPPED→
    "*sabort", EVT FAULT→"*fault enc (v4)"+"*sabort", EVT BUSY→"*busy"; ACK/HELLO
    gestiti internamente. Campioni con runId di un run vecchio vengono scartati
    (robustezza a reboot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
2026-07-20 UI: display del picco ("max N gradi X.XXX") non tronca piu' il valore mm
    Difetto visto al banco (foto): il display rosso accanto ad "Avanzate" mostrava
    "max 180 gradi 16" con il valore mm TAGLIATO sul bordo destro. Due cause:
    1. <form name="mas"> non era un flex item che cresce: l'input dentro aveva
    flex:1 ma il genitore no, quindi il campo restava alla min-width anche con
    spazio libero a destra (esattamente il quadro della foto).
    2. La stringa aveva 7 spazi fissi tra "gradi" e il valore -> ~300px di testo
    in un campo da ~200px.
    Fix:
    - style.css: form[name=mas] { flex:1; display:flex } cosi' il campo riempie lo
    spazio della riga; min-width 360px = la stringa piu' lunga (sommari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
2026-07-20 UI: tooltip Tastatore chiarisce il flusso standard (sempre puntalino)
    Osservazione del committente: il senso del banco e' misurare SEMPRE col
    puntalino e applicare bicchiere/piattello/bilanciere DOPO, matematicamente,
    in Analisi (follower virtuale). Corretto: da una misura a puntalino si deriva
    qualsiasi punteria, il contrario no (il piattello perde informazione sui
    fianchi). Il tooltip del selettore pero' non lo diceva e poteva far sembrare
    le opzioni alternative equivalenti.
    Ora il tooltip apre col flusso raccomandato e precisa che il campo va cambiato
    SOLO se si monta fisicamente altro (es. validazione della conversione, come
    fatto col piattello O33 sul Clio: 1,26 mm RMS apparenti -> 0,0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
2026-07-20 UI: rimosso il selettore Tastatore (decisione committente)
    Il flusso del banco e' per progetto: misura SEMPRE col puntalino, le punterie
    reali (bicchiere/piattello/bilanciere) si applicano DOPO matematicamente in
    Analisi (follower virtuale). Il selettore in Avanzate era quindi fuorviante:
    suggeriva che misurare con altri tastatori fosse un'alternativa equivalente.
    Rimosso tutto il percorso:
    - alzata.html: riga "Tastatore" nel pannello Avanzate (select probeType +
    help icon), persistenza localStorage 'cammes-probe-type', metadato
    '#tastatore=' nel salvataggio .scr (restano #verso/#microstep/#fw/
    #encoderSpan, che sono provenienza ancora valida).
    - analisi.html: avviso "Tastatori divers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
2026-07-20 Pulizie: sourceCommit reale in version.json + gitignore file accesso banco
    - fw/version.json: sourceCommit 'pending-commit-4.0' -> 7833b57 (il commit che
    ha prodotto la hex 4.0; master.ino invariato da allora, hexSha256 identico).
    - .gitignore: SETUP_BANCO_REMOTO.md e AVVIA_BANCO_REMOTO.bat restano SOLO su
    Drive: contengono IP Tailscale, utente del PC banco e istruzioni d'accesso,
    che non vanno nel repo PUBBLICO.
2026-07-20 Release v3.4.0: secondo giro audit (app 3.4.0, firmware 4.0, protocollo v4)
    Consolida tutto il lavoro post-v3.3.0 (22 commit, controrevisione Codex):
    - Integrita' misura: MET-01 (regressione corretta), parser rigoroso, APP-09,
    crossing reali MAT-03, convergenza DYN-02, epoca encoder MET-05.
    - Autorita' banco: controller lease MOT-04 + STOP su perdita MOT-03 (validati
    fisicamente), bridge server v4 MOT-02.
    - Firmware 3.7->4.0: FW-04/09/03 + protocollo v4 (FSM, ACK/NACK, EVT,
    heartbeat dedicato, fault latched, device id EEPROM) — bench 39/39 + 25/25.
    - Supply-chain: REL-07 chiuso (build riproducibile in CI), REL-10 SBOM,
    SEC-08 limiti WS.
    - UI: fix troncamento display picco, rimosso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
2026-07-20 UI: meccanismo live corretto — profilo non piu' specchiato/sfasato/mozzato
    Segnalazione dal banco (scan Clio): la camma disegnata nel widget "Meccanismo
    (live)" non somigliava a quella vera. Quattro difetti reali:
    1. SPECCHIATURA+FASE: lo scan standard gira in direzione 'S-' e l'encoder
    conta all'INDIETRO (-4 cnt/grado, misurato al banco), ma il widget mappava
    enc/4 dritto sull'indice di pdata -> profilo specchiato e sfasato. Ora la
    mappatura usa la direzione (rsign) e, quando disponibile, l'ancora
    picco (maxg/maxg_encoder, la stessa del 0-virtuale) -> robusta anche senza
    encoder azzerato a inizio scan. L'etichetta "cam N°" ora e' in gradi di
    SCANSIONE, coerente con l'a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
2026-07-20 UI Analisi: caselle parametri non tagliano piu' i valori
    Segnalazione dal banco: quasi tutte le caselle del pannello impostazioni
    mostravano i valori troncati ("650(" per 6500, "0,3(" per 0,30, "Bicchiere
    mec..."). Tre cause sommate:
    - width inline fisse (75px tipica) con padding .input da 14px per lato;
    - gli SPINNER dei type=number (Chrome ne riserva ~15px DENTRO la casella);
    - select in font mono largo con testi lunghi ("Bicchiere meccanico").
    Fix (scoped alle .param-row di analisi):
    - input: padding compatto 6/8, numeri allineati a destra, spinner nascosti
    (si digita; frecce tastiera ancora attive), flex-grow fino allo spazio
    della riga (width inline = solo base di partenza), max 15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
2026-07-20 UI: meccanismo live = indicatore di POSIZIONE con camma schematica
    Decisione committente: il banco e' universale (infinite camme/auto diverse) e
    NESSUN campo o valore va tarato su un modello specifico. Il widget live non ha
    caselle di configurazione (es. raggio base), quindi non deve dipendere da dati
    che non possiede: serve a confrontare a colpo d'occhio la POSIZIONE della
    camma disegnata con quella montata, non a riprodurne la forma.
    Ora il widget disegna una camma SCHEMATICA a proporzioni fisse (scelte solo
    per leggibilita' grafica) che:
    - ruota all'angolo REALE dell'encoder (mappatura direzione S- corretta);
    - se una scansione ha individuato il picco (maxg/maxg_encoder, automatici),
    o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
2026-07-20 Release v3.4.1: fix UI dal collaudo al banco (firmware 4.0 invariato)
    Consolida i tre fix emersi usando la v3.4.0 al banco con una camma reale:
    - Meccanismo (live) = indicatore di POSIZIONE con camma schematica (banco
    universale: niente forme/valori tarati su un modello specifico); corretti
    specchiatura/fase, tacche sui gradi mancanti, naso mozzato.
    - Analisi: caselle parametri non tagliano piu' i valori (padding, spinner,
    flex-grow, select proporzionali) — audit 38 campi, 0 tagli.
    - Display del picco in Alzata gia' in v3.4.0.
    Allineamenti: package.json/cammes-ui.js/README/RELEASE_MANIFEST a 3.4.1,
    CHANGELOG con voce v3.4.1. Gate: suite verde, lint 0. Firmware invariato (4.0,
    stessa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
2026-07-20 CTRL-01 [P0]: un frame WebSocket = una sola operazione (controrevisione v3.4.1)
    Difetto (riproducibile su v3.4.1): il gestore WS classificava il messaggio sul
    primo carattere/verbo e inoltrava il TESTO INTERO alla seriale. Frame
    concatenati o con testo extra aggiravano il lease e facevano eseguire al
    firmware comandi non autorizzati anche con un solo operatore / due schede:
    "?\nS+360\n" -> primo char '?' read-only -> inoltrato intero -> scan
    "xS+360\n" -> ramo STOP scriveva il testo ricevuto -> stop poi scan
    "0 STATUS\n1 SCAN ..." -> primo verbo read-only -> inoltro intero
    "S+360junk" -> accettato (bridgeOutgoing con regex non ancorata)
    Fix (cammes_server.js):
    - parseFrame(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
2026-07-20 FW-01 [P0]: watchdog v4 efficace anche durante lo SCAN [fw 4.1, non flashato]
    Difetto (controrevisione v3.4.1): stepperMove() rinnovava g_lastHeartbeatMs
    all'ingresso; autonomousScan() lo chiama a OGNI unità, quindi lo scan teneva
    vivo da solo il watchdog v4 e poteva arrivare a EVT DONE anche con l'host muto
    (niente '~'/HEARTBEAT). Il bench provava il timeout solo su MOVE (una sola
    chiamata a stepperMove), per questo passava.
    Fix (master/master.ino):
    - rimosso il refresh dell'heartbeat da stepperMove();
    - il riferimento heartbeat e' inizializzato UNA VOLTA all'accettazione del run
    (autonomousScan gia' lo faceva a inizio scan; aggiunto nel gestore MOVE) e
    rinnovato SOLO da '~' o HEARTBE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
    [master.ino]
2026-07-20 DATA-01 [P0]: un profilo incompleto non diventa piu' "completo" al salvataggio
    Difetto (controrevisione v3.4.1): "Salva profilo" in Analisi scriveva sempre
    360 righe con Number(curve[i]||0), e all'import rawIntake=camLift.slice()
    scartava la maschera di copertura (.slice() perde le proprieta' custom). Un
    profilo 30/360 salvato e riletto tornava 360/0: i 330 gradi mai misurati
    diventavano zeri FISICI e potevano rientrare in analisi/timing/cam card/
    conformita' come veri zeri.
    - lib/cammes-math.js: nuova serializeDiagnosticProfile(values, covered, extra)
    (pura, esportata): salva SOLO i gradi coperti + #stato=INCOMPLETO/#validCount/
    #missingCount. Un vero zero misurato (covered=true)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
2026-07-21 Export Excel (.xlsx) delle misure — evita l'estensione .scr (screensaver Win)
    Richiesta del proprietario: Windows tratta l'estensione .scr come SCREENSAVER
    (eseguibile), quindi i file di acquisizione salvati non si aprono con doppio
    click e destano allarme. Aggiunto un export .xlsx (Excel vero).
    - cammes_server.js: buildXlsxFromScr() genera un OOXML (un .xlsx E' uno zip di
    XML) riusando buildZip() gia' presente — nessuna libreria esterna. Due fogli:
    "Misura" (Grado | Alzata) e "Info" (stato/validi/mancanti/picco/provenienza).
    Route GET /api/export-xlsx/<nome>.scr con la stessa sicurezza di /api/file/
    (isSafeFilename, no path traversal, solo .scr). Parser condiviso con la UI
    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
2026-07-22 FW-01 follow-up: HELLO annuncia fw=4.1 (era rimasto 4.0) + guard versione
    Bug trovato validando al banco: emitHello() aveva la stringa hardcoded
    "fw=4.0" mentre 'v' e '*boot' erano gia' 4.1. Una divergenza subdola: il gate
    fw>=4.1 del bench harness (sez. watchdog SCAN) leggeva l'HELLO e avrebbe
    saltato il test; anche il server mostra fw dall'HELLO.
    - master.ino: HELLO fw=4.0 -> 4.1; hex ricompilato riproducibile (SHA 604c00c2,
    doppia build identica); version.json allineato.
    - test_fw_parser.js: nuovo guard "HELLO fw= allineato a version.json" (oltre a
    'v' e '*boot') per intercettare in futuro questa classe di divergenze.
    - Suite verde, lint 0.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
    [master.ino]
2026-07-23 FW-01 VALIDATO al banco (fw 4.1, COM5): v3 39/39 + v4 28/28
    Validazione hardware del fix watchdog-scan (controrevisione v3.4.1):
    - SCAN v4 senza heartbeat -> EVT STOPPED reason=HOST_TIMEOUT a ~5,3 s,
    NESSUN EVT DONE, firmware IDLE e responsivo dopo il timeout;
    - SCAN con heartbeat regolare completa; MOVE invariato;
    - regressione v3 completa 39/39 (watchdog host, tabort, parser, FREE,
    config strict, overflow, busy, fault-encoder sez. K).
    BONUS di valore: durante la sessione il banco aveva un GUASTO REALE
    (encoder fermo a 0 col motore in moto) e FW-03 ha fatto il suo mestiere:
    '*fault enc' durante lo scan — true-positive osservato sul campo, non
    simulato. Guasto poi riparato al banco e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
2026-07-23 CTRL-02 (parziale) + FLASH-01: FSM/correlazione server e interlock flash
    FLASH-01 [P1] (controrevisione v3.4.1):
    - flashInProgress acquisito in modo SINCRONO prima della SerialPort.list()
    asincrona (prima due richieste quasi simultanee superavano entrambe il check
    con seriale chiusa -> due avrdude sulla stessa porta); ogni percorso d'uscita
    rilascia il flag (failFlash);
    - guardia moto estesa: anche un run v4 attivo (scan bridge) blocca il flash.
    - Test tools/test_flash_interlock.js: server con --com COMFAKE99 (ramo async
    reale, nessun avrdude parte mai) -> due POST simultanee = esattamente UNA
    "Flash gia' in corso" (sul codice vecchio entrambe ricevevano l'errore
    porta); flag ril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
2026-07-23 DATA-02 [P1]: assenza e zero distinti in parser, media e verdetto banco
    Difetto (controrevisione v3.4.1): Number('')===0 e Number(null)===0
    trasformavano l'ASSENZA di un dato in uno ZERO misurato valido:
    - parseCamFile("42,") -> grado 42 coperto, valore 0, ok=true;
    - averageRuns con null al grado 42 -> media 0.5 (null contava come 0);
    - benchVerdict su array di null/'' -> zeri "perfetti" -> falso PASS possibile;
    - un file coerente 0..359 veniva letto 359/360 senza riconoscere la convenzione.
    Fix (lib/cammes-math.js):
    - parseFiniteMeasurement(tok): helper UNICO esportato — null/undefined/''/
    whitespace/testo -> null (assente); '0' -> 0 (zero vero).
    - parseCamFile a DUE passi: parsing rig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
2026-07-23 Release v3.4.2: P0 controrevisione funzionale + export Excel (firmware 4.1)
    Consolida il terzo giro: CTRL-01 (frame WS atomici), DATA-01 (round-trip
    profili incompleti onesto), FW-01 (watchdog scan, fw 4.1 VALIDATA al banco
    v3 39/39 + v4 28/28), FLASH-01 (interlock), CTRL-02 parziale (stato vivo,
    filtro runId, finestra STOPPING, snapshot), DATA-02 (assenza != zero,
    convenzione 0..359), export Excel .xlsx dall'archivio.
    Allineamenti REL-01 (parziale): package-lock a 3.4.2 (--package-lock-only),
    SBOM rigenerato (app 3.4.2 / fw 4.1), RELEASE_MANIFEST con hex 604c00c2 e
    openItems onesti, CHANGELOG v3.4.2, README. Gate: suite 280+ verdi
    (un run intermedio con ETIMEDOUT su localhost = flakiness d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
2026-07-23 DATA-03 + DATA-04: media solo sui run completi + gate unico di valutabilita'
    DATA-03 (P1): la media dei run ripetuti includeva anche i run interrotti
    (gradi mancanti = buchi che alteravano la media per grado con n variabile).
    Ora averageCompleteRuns() classifica i run (completo/escluso con conteggio
    gradi mancanti), la media ufficiale usa SOLO i run completi e la UI dichiara
    "N/M run in media" + toast con l'elenco degli esclusi. 0 run completi =
    nessun risultato ufficiale.
    DATA-04 (P1): il giudizio "valutabile" era sparso e aggirabile (T15: file
    legacy zero-riempito con #stato=INCOMPLETO passava perche' missingCount=0).
    Ora canProduceOfficialResult() e' il gate UNICO (meta INCOMPLETO, conve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
2026-07-23 DYN-01 + DYN-02: convergenza tipizzata che blocca i verdetti + zero valido
    DYN-02 (P1): il pattern `Number(x) || default` sostituiva silenziosamente
    lo ZERO ESPLICITO col default (damping 0 -> 0.06 in 8 punti di raccolta UI
    e in simulateSpringSurge, dove un testo invalido propagava perfino NaN).
    Ora: helper unico finiteOr(v, d) esportato dalla lib (assente/vuoto/non
    numerico -> default; zero finito -> zero), usato in tutti i punti di
    raccolta (damping, massa molla, spire) e nel surge (zeta con range [0,1]
    applicato a parte). Il surge a cicli fissi si dichiara preliminare
    (preliminary=true, settleCycles) perche' non ha verifica di convergenza.
    DYN-01 (P1): i solver esponevano converged=true/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
2026-07-23 MAT-01: doughnut/tabella/PDF dagli eventi REALI, due lobi = AMBIGUOUS
    Il doughnut di fasatura riceveva centro e durata e ricostruiva gli archi
    come centro±durata/2: su lobi asimmetrici la FIGURA contraddiceva la
    tabella (che gia' usava i crossing reali di findEvents). Inoltre con DUE
    lobi distinti sopra soglia findEvents partiva dal picco globale e
    restituiva silenziosamente la coppia attorno ad esso, ignorando l'altro
    lobo; due plateau equivalenti sceglievano il primo.
    lib/cammes-math.js — findEvents riscritta a REGIONI:
    - scansione di TUTTI i crossing del giro (interpolati sub-grado, wrap
    720->1 gestito spezzando l'arco);
    - regola documentata: candidato = regione col picco sopra
    th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
2026-07-23 MAT-02: reindexByEncoder rimossa esplicitamente (percorso morto e permissivo)
    Il rilievo: la validazione di reindexByEncoder era troppo permissiva
    (accettava un giro al 90%, span al 150%, sequenze con inversioni) e il
    handoff offriva due strade: irrigidirla, oppure "se questa funzione non
    e' piu' usata dalla UI, valutarne la rimozione esplicita invece di
    mantenerla come percorso apparentemente affidabile".
    E' la seconda: l'opzione di re-indicizzazione encoder e' stata ritirata
    dalla UI il 2026-07-05 dopo la validazione al banco (passi ed encoder
    coincidono entro 1 grado sull'intero giro) e nessun codice la chiama
    piu' — solo il suo test di regressione. Tenerla in lib con una
    validazione d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
2026-07-23 APP-01: parameterHash su ogni export + retune live ATOMICO
    Il rilievo: il live tuning aggiornava il riepilogo forze e gli input di
    lastAnalysis ma NON gli array per grado (il CSV esportava forze VECCHIE
    sotto un riepilogo nuovo) ne' la cinematica in dominio tempo (dipende da
    rpm); con compliance OFF non marcava mai stale; i listener non coprivano
    follower (diamBicch/rRoll/lArm/lValve/fingerTilt), tipi lato e surge
    (surgeEnabled/springMass/springCoils).
    analisi.html:
    - parameterHash (djb2 di TUTTI gli input influenti + impronta dei profili
    caricati) e analysisId fotografati a fine analyze(); ogni export
    (CSV/PDF/cam card/race report via exportBlockedByStale) ricalcola
    l'hash e BLOCCA s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
2026-07-23 REL-02: gate di release completi (npm ci, lint, fw del tag, SBOM, smoke exe)
    Il workflow release usava npm install (drift possibile rispetto al
    lockfile), non eseguiva il lint, non ricompilava il firmware all'esatto
    tag di release e non provava mai l'EXE prodotto.
    .github/workflows/release.yml:
    - nuovo job firmware-gate (needs: della build): ricompila master.ino
    al commit del tag col core AVR pinnato (arduino:avr@1.8.7, come
    firmware.yml) e verifica lo SHA256 di fw/version.json — l'HEX
    imbarcato nell'exe e' provato riproducibile DAL TAG, non da un push
    qualsiasi;
    - npm ci dal lockfile al posto di npm install;
    - lint come gate (prima solo test);
    - SBOM: rigenerato in CI (tools/gen_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
2026-07-23 REL-03: linguaggio coerente — "STOP software", niente sistemi di emergenza
    Per decisione del proprietario il prodotto NON prevede sistemi di
    emergenza fisica: dove si descrive il prodotto corrente, "STOP di
    emergenza"/"E-stop"/"fungo" diventano "STOP software" e le richieste
    di nuovo hardware di emergenza escono dal piano corrente.
    - README.md: 2 occorrenze (tabella Alzata, requisiti firmware);
    - alzata.html: 2 commenti (toast *mabort, invio 'x');
    - tools/bench_v4_test.js: 1 commento;
    - master/master.ino: 1 commento in stepperMove (SOLO commento: il
    binario compilato e' identico, la CI firmware lo riverifica al push);
    - MOTION_CONTROL_MODEL.md: perimetro riformulato (STOP software,
    wa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
